tuannv-github/uwb-ips/README.md

# UWB indoor positioning system

Demo videos:
* https://www.youtube.com/watch?v=icayNw2rwgk
* https://www.youtube.com/watch?v=bJMFOIG7K60
