tuannv-github/uwb-ips/software/algorithm/multilateration/readme.md

# Source code for multilateration problem
## Generate sample data:
```
python location_generator.py
```
## Test Python implementation:
```
python multilateration.py
```
## Test Javascript implementation:
```
node multilateration.js
```
## Test C implementation:
```
gcc multilateration.c -o multilateration -lm
./multilateration
```
