tuannv-github/uwb-ips/firmware/apps/relay/README.md

```
newt target create relay
newt target set relay app=apps/relay
newt target set relay bsp=hw/bsp/nordic_pca10040_464
newt target set relay build_profile=optimized
newt build relay
newt create-image relay 0.0.0.0
newt load relay
```

```
newt target create relay
newt target set relay app=apps/relay
newt target set relay bsp=@apache-mynewt-core/hw/bsp/nordic_pca10040
newt target set relay build_profile=optimized
newt build relay
newt create-image relay 0.0.0.0
newt load relay
```

```
newt target create relay
newt target set relay app=apps/relay
newt target set relay bsp=@apache-mynewt-core/hw/bsp/nordic_pca10056
newt target set relay build_profile=optimized
newt target set relay syscfg=STATS_NAMES=1
newt build relay
newt create-image relay 0.0.0.0
newt load relay
```
