tuannv-github/uwb-ips/reports/thesis.tex

\documentclass[oneside, 12pt, a4paper]{book}

\usepackage[utf8]{inputenc}
\usepackage[english]{babel}

\usepackage{url}
\usepackage{tikz}
\usetikzlibrary{calc}
\usepackage{float}
\usepackage{ifthen}
\usepackage{siunitx}
\usepackage{lmodern}
\usepackage{amsmath}
\usepackage{listings}
\usepackage{graphicx}
\usepackage{subfiles}
\usepackage{biblatex}
\usepackage{csquotes}
\usepackage{tabularx}
\usepackage{multirow}
\usepackage{geometry}
\usepackage{enumitem}
\usepackage{pdfpages}
\usepackage{bytefield}
\usepackage{microtype}
\usepackage{alphabeta}
\usepackage{subcaption}
\usepackage{xcolor,colortbl}
% \usepackage[Lenny]{fncychap}
\usepackage[titletoc]{appendix}
\usepackage[hidelinks]{hyperref}

\usepackage{pythonhighlight}

\providecommand{\main}{.}
\addbibresource{\main/references.bib}   

\usepackage{\main/sty/slashbox}

\newboolean{printBibInSubfiles}
\setboolean{printBibInSubfiles}{true} 
\def\bib{\ifthenelse{\boolean{printBibInSubfiles}}
        {\printbibliography}
        {}
    }

\definecolor{Gray}{gray}{0.85}
\definecolor{LightCyan}{rgb}{0.2,0.7,1}

\newcolumntype{g}{>{\columncolor{Gray}}c}
\newcolumntype{w}{>{\columncolor{white}}c}
\newcolumntype{L}{>{\arraybackslash}X}
\newcolumntype{M}[1]{>{\centering\arraybackslash}m{#1\textwidth}}

\newlist{abbrv}{itemize}{1}
\setlist[abbrv,1]{label=,labelwidth=1in,align=parleft,itemsep=0.1\baselineskip,leftmargin=!}

\DeclareMathOperator*{\argmax}{argmax} 
\DeclareMathOperator*{\argmin}{argmin} 

\graphicspath{{img/}}

\geometry{
    left=20mm,
    right=20mm,
    top=20mm,
    bottom=20mm,
}

\setlength\parindent{0pt}

\definecolor{solarized@base03}{HTML}{002B36}
\definecolor{solarized@base02}{HTML}{073642}
\definecolor{solarized@base01}{HTML}{586e75}
\definecolor{solarized@base00}{HTML}{657b83}
\definecolor{solarized@base0}{HTML}{839496}
\definecolor{solarized@base1}{HTML}{93a1a1}
\definecolor{solarized@base2}{HTML}{EEE8D5}
\definecolor{solarized@base3}{HTML}{FDF6E3}
\definecolor{solarized@yellow}{HTML}{B58900}
\definecolor{solarized@orange}{HTML}{CB4B16}
\definecolor{solarized@red}{HTML}{DC322F}
\definecolor{solarized@magenta}{HTML}{D33682}
\definecolor{solarized@violet}{HTML}{6C71C4}
\definecolor{solarized@blue}{HTML}{268BD2}
\definecolor{solarized@cyan}{HTML}{2AA198}
\definecolor{solarized@green}{HTML}{859900}

\lstdefinestyle{CStyle}{
    language=C,
    basicstyle=\footnotesize\ttfamily,
    numbers=left,
    numberstyle=\footnotesize,
    tabsize=2,
    breaklines=true,
    escapeinside={@}{@},
    numberstyle=\tiny\color{solarized@base01},
    keywordstyle=\color{solarized@green},
    stringstyle=\color{solarized@cyan}\ttfamily,
    identifierstyle=\color{solarized@blue},
    commentstyle=\color{solarized@base01},
    emphstyle=\color{solarized@red},
    frame=single,
    rulecolor=\color{solarized@base2},
    rulesepcolor=\color{solarized@base2},
    showstringspaces=false
}

\lstdefinestyle{XMLStyle}{
    language=xml,
    tabsize=2,
    frame=single,
    xleftmargin=20pt,
    framexleftmargin=15pt,
    keywordstyle=\color{blue}\bf,
    commentstyle=\color{OliveGreen},
    stringstyle=\color{red},
    numbers=left,
    numberstyle=\tiny\color{solarized@base01},
    numbersep=5pt,
    breaklines=true,
    showstringspaces=false,
    basicstyle=\footnotesize,
    emphstyle={\color{magenta}},
    rulecolor=\color{solarized@base2},
    rulesepcolor=\color{solarized@base2},
    basicstyle=\footnotesize\ttfamily,
}

\begin{document}
\setboolean{printBibInSubfiles}{false}

\subfile{00_misc/cover.tex}

\clearpage
\setcounter{page}{1}

\subfile{00_misc/task.tex}
\subfile{00_misc/ack.tex}
\subfile{00_misc/assurance.tex}
\subfile{00_misc/abs.tex}

\tableofcontents

\subfile{00_misc/fig.tex}
\subfile{00_misc/tab.tex}
\subfile{00_misc/sym.tex}

\subfile{01_intro/introduction.tex}
\subfile{02_theory/ultra_wideband.tex}
\subfile{position_estimation/position_estimation.tex}

\subfile{03_firmware/firmware.tex}

\subfile{ble_mesh/ble_mesh.tex}

\subfile{04_hardware/hardware.tex}
\subfile{05_software/software.tex}
\subfile{06_result/result.tex}

\subfile{summary/summary.tex}

\begin{appendix}
    \includepdf[pages=1, pagecommand={
        \chapter{RTLS anchor board (Altium Designer)}
        \label{appendix:rtls_anchor_board}
    }, width=\textwidth, offset=0 -1cm]{\main/docs//RTLS-2021-01-09--13-27.PDF}

    \includepdf[pages=2-,pagecommand={},width=\textwidth]{\main/docs/RTLS-2021-01-09--13-27.PDF}
    
    \chapter{RTLS anchor enclosure (SolidWorks)}
    \label{appendix:rtls_anchor_enclosure}
    % \begin{figure}[H]
    %     \begin{center}
    %         \includegraphics[angle=90, width=0.65\textwidth]{Assem.JPG}
    %     \end{center}
    %     \caption{RTLS SolidWorks design}
    %     \label{fig:RTLS_SolidWork_Design}
    % \end{figure}
    % \begin{figure}[H]
    %     \centering
    %     \includegraphics[angle=90, width=0.65\textwidth]{anchor_final.jpg}
    %     \caption{RTLS anchor}
    %     \label{fig:RTLS_anchor}
    % \end{figure}
    \begin{figure}[H]
        \begin{center}
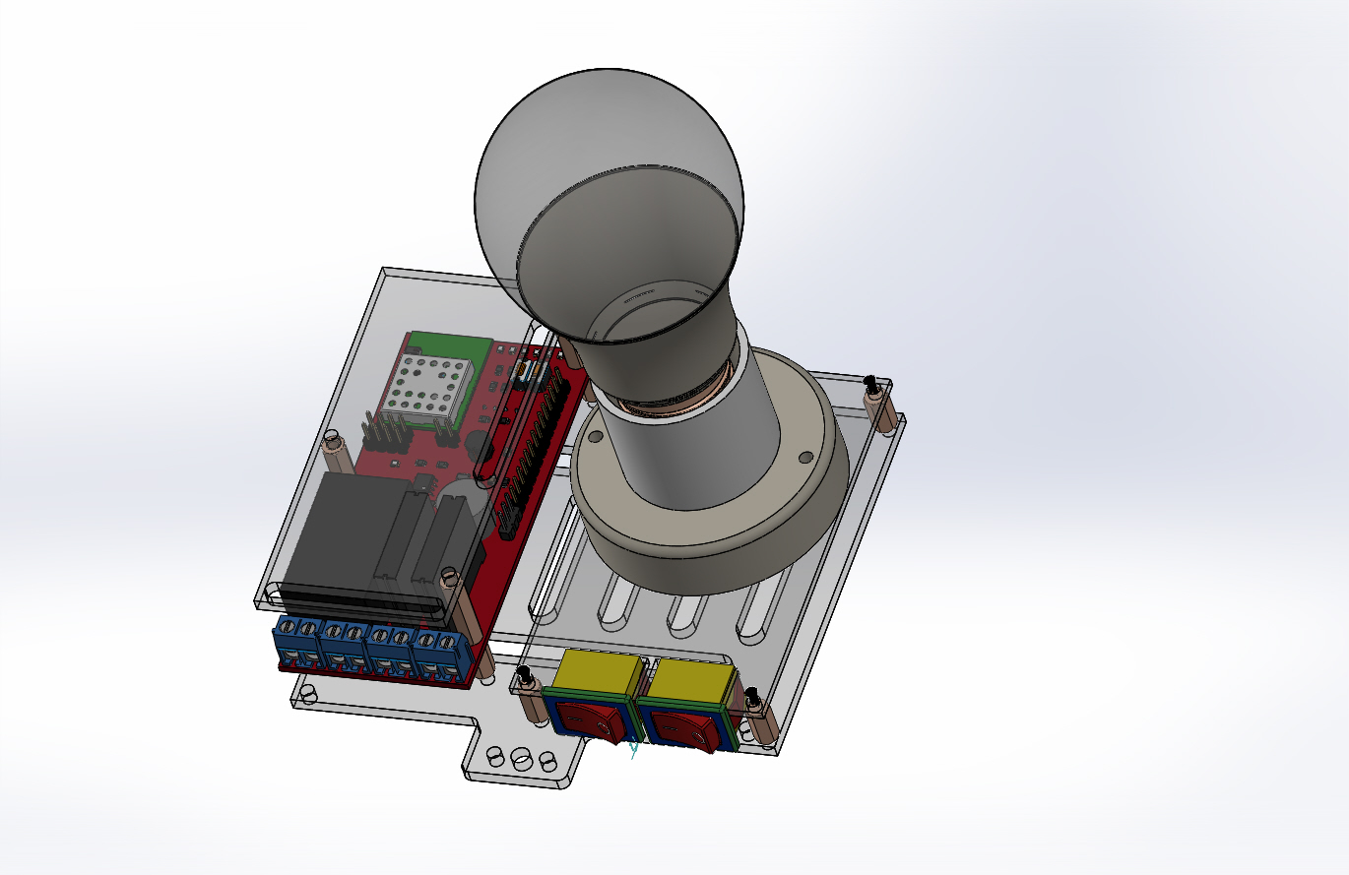
[picture p66: reports/imgs/Assem.JPG]
            
        \end{center}
        \caption{RTLS SolidWorks design}
        \label{fig:RTLS_SolidWork_Design}
    \end{figure}
    \begin{figure}[H]
        \centering
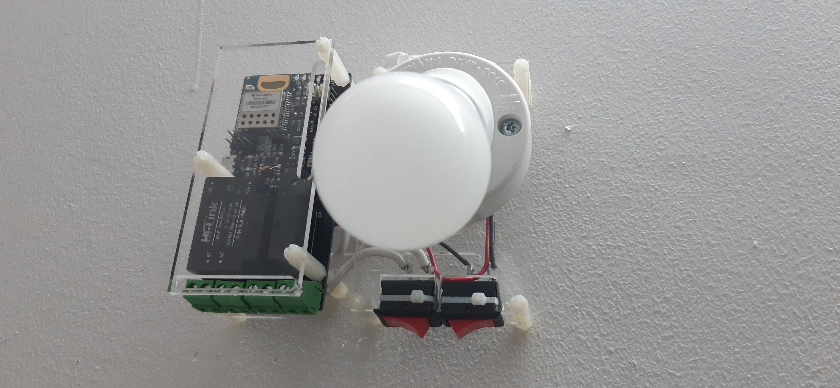
[picture p67: reports/img/anchor_final.jpg]
        
        \caption{RTLS anchor}
        \label{fig:RTLS_anchor}
    \end{figure}
\end{appendix}

\printbibliography[heading=bibintoc,title={References}]

\end{document}
