tuannv-github/uwb-ips/reports/00_misc/assurance.tex

\providecommand{\main}{..}
\documentclass[\main/thesis.tex]{subfiles}

\begin{document}
\graphicspath{{imgs/}{00_misc/imgs/}}

\chapter*{Assurance}
\addcontentsline{toc}{chapter}{Assurance}

My name is Ngo Van Tuan, I am a student at the Department of Electronics and Telecommunications, Ho Chi Minh University of Technology.
\newline\newline
I hereby declare that the following contents are true:
\begin{itemize}
    \item This research work is entirely done by myself;
    \item Materials and citations contained in this thesis are obtained from reputable sources with high accuracy;
    \item The data and results of this work are independently and honestly done by me;
\end{itemize}

In addition, a number of comments, reviews as well as data from other authors and organizations used in the thesis have clear citations and references.

\begin{flushright}
    \parbox[t][4cm]{8cm}
    {   \centering
        \today\\
        Student\\
        \vspace{2cm}
        Ngo Van Tuan
    }
\end{flushright}

\end{document}
