tuannv-github/uwb-ips/reports/00_misc/cover.tex

\providecommand{\main}{..}
\documentclass[\main/thesis.tex]{subfiles}

\begin{document}
\graphicspath{{imgs/}{00_misc/imgs/}}

    \pagestyle{empty}
    \begin{minipage}[b][3cm][t]{17.5cm}
        % Draw border
        \begin{tikzpicture}[remember picture, overlay]
            % Thin line
            \draw [line width=1pt]
                ($ (current page.north west) + (1.5cm,-1.5cm) $)
                rectangle
                ($ (current page.south east) + (-1.5cm,1.5cm) $);
            % Thick line
            \draw [line width=3pt]
                ($ (current page.north west) + (1.65cm,-1.65cm) $)
                rectangle
                ($ (current page.south east) + (-1.65cm,1.65cm) $); 
        \end{tikzpicture}

        \begin{center}
            \begin{large}
                    {VIETNAM NATIONAL UNIVERSITY HO CHI MINH CITY\\
                     HO CHI MINH CITY UNIVERSITY OF TECHNOLOGY\\
                     FACULTY OF ELECTRICAL AND ELECTRONICS  ENGINEERING\\
                     DEPARTMENT OF ELECTRONICS AND TELECOMMUNICATIONS}\\[0.2cm]
            \end{large}
            \textbf{*******************************************************}\\[1.5cm]
            \\[1.5cm]
                {\fontsize{20}{1}\selectfont Graduation Thesis }\\[1.5cm]
                {\fontsize{18}{24}\selectfont \textbf{\parbox[c][3cm]{15cm}{\centering DESIGN AND IMPLEMENTATION OF INDOOR LOCALIZATION SYSTEM USING UWB AND WIRELESS MESH NETWORK}} }\\[3.0cm]
        \end{center}

        {
            \fontsize{15}{1}\selectfont
            \begin{flushright}
            \parbox[t][4.5cm]{8cm}
            {
                Supervisor: Dr. Vo Que Son\\[4pt]
                % Reviewer: Dr. Vo Que Son\\[4pt]
                Student: Ngo Van Tuan - 1613861
            }
            \end{flushright}
        }
        
        \vspace{1cm}
        \begin{center}
            {\fontsize{14}{1}\selectfont Ho Chi Minh City, \today }
        \end{center}

    \end{minipage}
    \newpage
\end{document}
