tuannv-github/uwb-ips/reports/00_misc/sym.tex

\providecommand{\main}{..}
\documentclass[\main/thesis.tex]{subfiles}
\graphicspath{{img/}{00_misc/img/}}

\begin{document}

\chapter*{Symbols and acronyms}
\addcontentsline{toc}{chapter}{Symbols and Acronyms}
\begin{abbrv}
    \item[IPS]  Indoor positioning system
    \item[GPS]  Global positioning system 
    \item[SFD]  Start Frame Delimiter
    \item[SHR]  Synchronization Header
    \item[PHR]  Physical Header
    \item[PPDU] Physical Protocol Data Unit
    \item[PRF]  Pulse Repetition Frequency
    \item[MOSFET]  Metal-Oxide Semiconductor Field-Effect Transistor
    \item[ESR]  Equivalent Series Resistance
    \item[PDU] Packet Data Unit
    \item[IV] Initialization Vector
    \item[UUID] Universal Unique Identifier 
    \item[SOF] Single point of failure  
    \item[MQTT] Message Queuing Telemetry Transport 
    \item[QoS] Quality of Service
    \item[ToF] Time of Flight
    \item[TWR] Two-Way Ranging
    \item[CCP] Clock Calibration Packet  
    \item[TDMA] Time Division Multiple Access 
    \item[EIRP] Effective Isotropic Radiated Power
    \item[TH] Time-hoping 
    \item[RSSI] Received Signal Strength Indication
    \item[LoF] Line of Sight
    \item[RF] Radio Frequency 
    \item[UWB] Ultra-wide Band 
    \item[IR-UWB] Impulse-Radio Ultra-Wideband 
    \item[IoT] Internet of Things
\end{abbrv}

\end{document}
