tuannv-github/uwb-ips/reports/00_misc/task.tex

\providecommand{\main}{..}
\documentclass[\main/thesis.tex]{subfiles}

\begin{document}
\graphicspath{{imgs/}{00_misc/imgs/}}

% \noindent\makebox[\linewidth]{}

\rule{\textwidth}{1pt}
\begin{minipage}{0.45\textwidth}
    \vspace{3mm}
    \begin{center}
        \fontsize{7}{12}\selectfont{VIETNAM NATIONAL UNIVERSITY HO CHI MINH CITY\\
                 HO CHI MINH CITY UNIVERSITY OF TECHNOLOGY\\}
    \rule{\textwidth}{1pt}
    \end{center}
\end{minipage}
\hfill
\begin{minipage}{0.45\textwidth}
    \vspace{3mm}
    \begin{center}
        \fontsize{7}{12}\selectfont{SOCIALIST REPUBLIC OF VIETNAM\\
    INDEPENDENCE-FREEDOM-HAPPINESS\\}
    \rule{\textwidth}{1pt}
    \end{center}
\end{minipage}

\begin{flushleft}
    \parbox[t][1.5cm]{10cm}
    {
        Number: ....................... /BKĐT \\
        Faculty: Electrical and Electronics Engineering \\
        Department: Telecommunications
    }
\end{flushleft}

\vspace{3mm}
\begin{center}
    \textbf{THESIS MISSION}
\end{center}
\vspace{3mm}

\begin{enumerate}
    \item Student name: Ngo Van Tuan \hspace{3cm} Student ID: 1613861
    \item Faculty: Electrical and Electronics
    \item Department: Telecommunications
    \item Topic: Design and implementation of indoor localization system using UWB and wireless mesh network 
    \item Task: \begin{itemize}
        \item Design and implement an indoor localization system using UWB
        \item Build a system to manage and control the localization system based on Bluetooth mesh network.
    \end{itemize}
    \item Start date: 20/9/2020
    \item Due date: 11/1/2020
    \item Supervisor: Dr. Vo Que Son, Department of Telecommunications
\end{enumerate}

Contents and requirements have been accepted by the department.
\newline\newline
Ho Chi Minh City, \today

\vspace{10mm}

\begin{minipage}{0.45\textwidth}

    \begin{center}
        \textbf{\fontsize{14}{12}\selectfont{
            HEAD OF DEPARTMENT}}\\
            \vspace{2cm}
            Assoc. Prof. Ha Hoang Kha
    \end{center}
\end{minipage}
\hfill
\begin{minipage}{0.45\textwidth}
    \begin{center}
        \textbf{\fontsize{14}{12}\selectfont{SUPERVISOR}} \\
        \vspace{2cm}
        Dr. Vo Que Son
    \end{center}
\end{minipage}

\newpage
% PH DÀNH CHO KHOA, B¸ M˘N:

\textbf{Department area}

Approved by:

Department:

Thesis defense date:

Score:

Storage location:

\end{document}
