tuannv-github/uwb-ips/reports/02_theory/ultra_wideband.tex

\providecommand{\main}{..}
\documentclass[\main/thesis.tex]{subfiles}

\begin{document}
\graphicspath{{img/}{02_theory/img/}}

% \chapterimage{chapter_head_1.pdf}
\chapter{Ultra-Wideband Signals}

This chapter provides a quick explanation of UWB along with its advantages and regulations. The later 2 sections also give a modulation scheme and the IEEE standard for UWB.

\section{Definition of Ultra-Wideband System}

With $f$\textsubscript{c} is the frequency in which the system has the maximum power density and the frequencies $f$\textsubscript{h} and $f$\textsubscript{L} determine the location where the power of spectral density is 10dB less then the $f$\textsubscript{c}. $B$\textsubscript{frac} is defined as 
\begin{equation}
    B\textsubscript{frac}=\frac{B}{f\textsubscript{c}}
\end{equation} where $B$ is the bandwidth of the system.

In term of high and low frequencies, we have: 
\begin{equation}
    B=(f\textsubscript{H} - f\textsubscript{L})
\end{equation}
and 
\begin{equation}
    f\textsubscript{c} = \frac{f\textsubscript{H} + f\textsubscript{L}}{2}\
\end{equation} 
so 
\begin{equation}
    B\textsubscript{frac} = \frac{2(f\textsubscript{H} - f\textsubscript{L})}{f\textsubscript{H} + f\textsubscript{L}}
\end{equation}

The Federal Communication Commission (FCC) has define UWB systems as those which have an absolute bandwidth larger than 500Mhz and $f$\textsubscript{c} larger than 2.5 GHz, or have a $B$\textsubscript{frac} larger than 0.2 for system with $f$\textsubscript{c} lower than 2.5GHz \cite{ultra_wideband_positioning_systems}.

Ultra-Wideband radio is also referred as ‘impulse’, ‘short-pulse’, ‘non-sinusoidal’, ‘carrierless’, ‘time domain’, ‘super wideband’, ‘fast frequency chirp’ and ‘mono-pulse’ radio.

Very short pulse transmissions that result in an ultra-wideband spectrum are both utilized by impulse radio communication systems and impulse radars. Since the data modulation is introduced by pulse position modulation,  this communication manner is also classified as a pulse modulation technique (PPM).

Due to the low-power spectral density, the UWB signal is noise-like which make the interception and detection quite difficult. On the other hand, this makes UWB cause very little interference with existing narrow-band radio systems. Moreover, UWB might operate without license depend on the attitude of national and international regulatory bodies.

One result of the large bandwidth of UWB is that due to the inverse relationship of
time and frequency. Figure \ref{fig:uwb_versus_other_radio_communication_systems} shows the differences between UWB and other radio systems in the frequency band and power spectral density.

\begin{figure}[H]
    \centering
    
    \caption{UWB versus other radio communication systems}
    \label{fig:uwb_versus_other_radio_communication_systems}
\end{figure}

\section{Advantages of Ultra-Wideband}

Below \cite{uwb_theory_and_applications} are some advantages that make it attractive for consumer communication applications.
\begin{itemize}
    \item Potentially low complexity and low cost
    \item Noise like signal
    \item Resistant to multi-path and jamming
    \item Good time-domain resolution allowing for localization and tracking application.
\end{itemize}

The base-band nature of signal transmission reduces the complexity and cost of UWB systems.
Unlike conventional radio systems, a very short time-domain pulse produced by the UWB transmitter is able to propagate without the need of an additional RF mixing stage. 
% The RF mixing stage takes a base-band signal and `inject' carrier frequency or translates the signal to a frequency which has desirable propagation characteristic. 
% The very nature of the UWB signal means it spans frequencies commonly used as carrier frequencies. 
% The signal will propagate well without the need of additional up-conversion and amplification. 
There is no need of additional up-conversion and amplification and the sender side.
The reverse process of down-conversion is also not required in the UWB receiver. This means the omission of a local oscillator in the receiver, and the removal of associated complex delay and phase tracking loop. Consequently, a UWB system can be implemented in low cost, low power, integrated circuit process.

One of the most important topics in current UWB research is the interference phenomenon between impulse radio and existing radio systems. While there is some debate in the literature, it appears that low power, noise-like, UWB transmission does not significantly interfere existing radio systems. The low energy of and the pseudo-random (PR) characteristics of the UWB signal, however, make it noise-like, thus making it quite difficult to detect unintended signals. 

% Time-modulation systems offer a possibility for high data rates for communication. Hundreds of Mbps have been reported for communication links.

Using UWB technology, a very high multi-path resolution is achieved because of the large bandwidth of the transmitted signal. The large bandwidth offers huge frequency diversity which, together with the discontinuous transmission, make the UWB signal resistant to severe multi-path propagation and jamming/interference. 

The very narrow time-domain pulse of UWB radios means that it is potentially able to offer timing precision much better than other radio systems. Together with good material penetration properties, UWB signals offer opportunities for short-range radar applications such as rescue and anti-crime operations, as well as in surveying and the mining industry. UWB does not provide precise timing and extreme penetration at the same time, but UWB waveforms present a better choice than do conventional radio systems.

\section{International Regulations for UWB Signals}

The effective isotropic radiated power (EIRP) which can be defined as the product of its gain and input power is one important feature of a radar and communications transmitter . Figure \ref{fig:fcc_spectral_mask_for_indoor_uwb_systems} shows the FCC spectral mask of the indoor UWB EIRP emission level. It is evidence that the maximum signal power is limited to -41.3 dBm per MHz throughout the whole UWB frequency range from 3.1 to 10.6 GHz. To comply with the FCC standards and regulations, all UWB systems and devices must work within this spectral mask for legal operation.

\begin{figure}[H]
    \centering
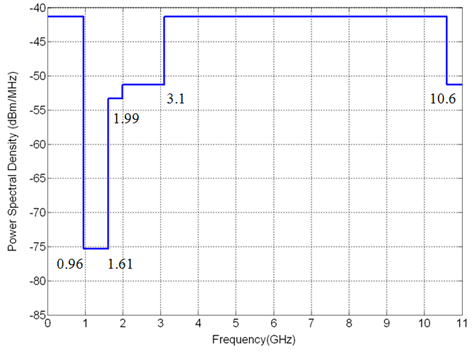
[picture p68: reports/02_theory/img/fcc_spectral_mask_for_indoor_uwb_systems.png]
    
    \caption{FCC spectral mask for indoor UWB systems}
    \label{fig:fcc_spectral_mask_for_indoor_uwb_systems}
\end{figure}

\section{Relationship of Bandwidth with Data Rate and Power Consumption}
As indicated by the Shannon-Harley theorem, there is a direct relationship between capacity and bandwidth and an inverse relationship between bandwidth and power consumption. Their theorem states: 
\begin{equation}
    C=B\log_2(1+\frac{S}{N})
\end{equation} where $C$ is the capacity ($bits/second$), $B$ is the bandwidth, $S$ is the average received signal power over $B$ and $N$ is the average noise over $B$. 

For a specific capacity, it consumes less power with a larger bandwidth. Since $\frac{S}{N}$ is under a logarithm, it is easier to increase the capacity by increasing of the bandwidth instead of $\frac{S}{N}$. It is common to refer to $\frac{S}{N}$ as SNR, the Signal to Noise Ratio. Figure \ref{fig:capacity_versus_bandwidth_curves_for_uwb_systems_over_awgn_channels} \cite{ultra_wideband_positioning_systems} shows the relationship between the bandwidth and the capacity for five different SNRs.

\begin{figure}[H]
    \centering
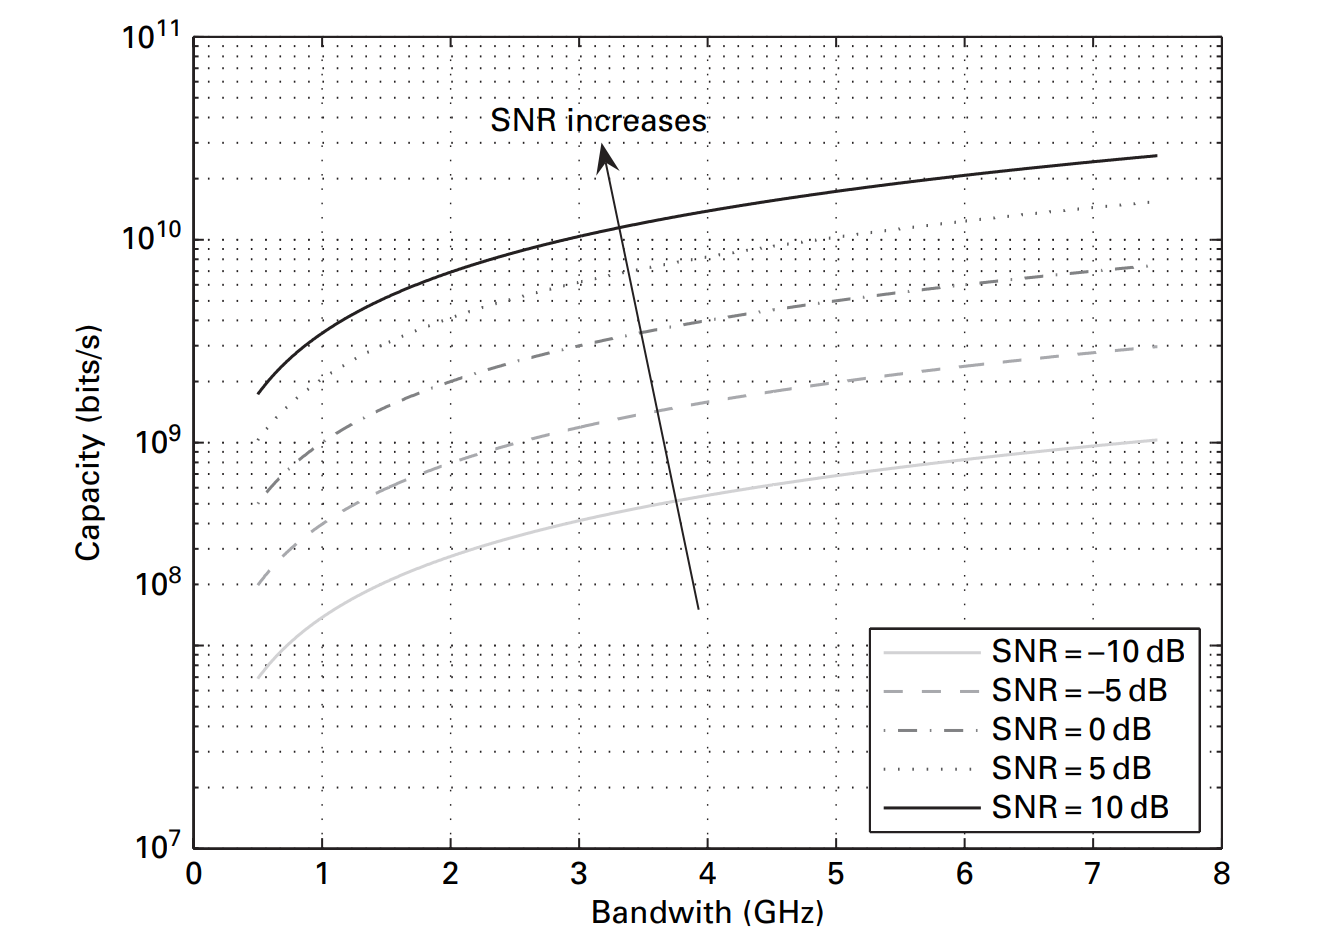
[picture p69: reports/02_theory/img/capacity_versus_bandwidth_curves_for_uwb_systems_over_awgn_channels.PNG]
    
    \caption{Capacity versus bandwidth curves for UWB systems over AWGN channels}
    \label{fig:capacity_versus_bandwidth_curves_for_uwb_systems_over_awgn_channels}
\end{figure}

\section{An UWB Modulation Scheme: Impulse Radio Scheme}

Time-modulated ultra wide-band (TM-UWB) communication is based on discontinuous emission of very short Gaussian pulses or other types of pulse waveforms (monocycles).

As in figure \ref{fig:an_ir_uwb_signal} \cite{ultra_wideband_positioning_systems}, data is transmitted by low duty UWB signals information of the symbol is conveyed by position and/or polarity of the signal. Each symbol corresponds to one or more signals. In the following example, two consecutive IR signals represent one symbol. The IR signal can occupy one of the chip-intervals($T\textsubscript{$c$}$) within a frame ($T\textsubscript{$f$}$). A time-hoping (TH) code is used for determining the accurate position of a signal in a dedicated time frame to decrease the chance of interference between UWB systems. 

% In the following example, the TH codes for the symbols are \{2,1\}, \{2,3\} and \{1,0\} respectively, 
% In this example, the information corresponds to the polarity of the signals, so the IR stream represents the binary data `101'. This technique is commonly known as Binary Phase Shifts Keying (BPSK).

\begin{figure}[H]
    \centering
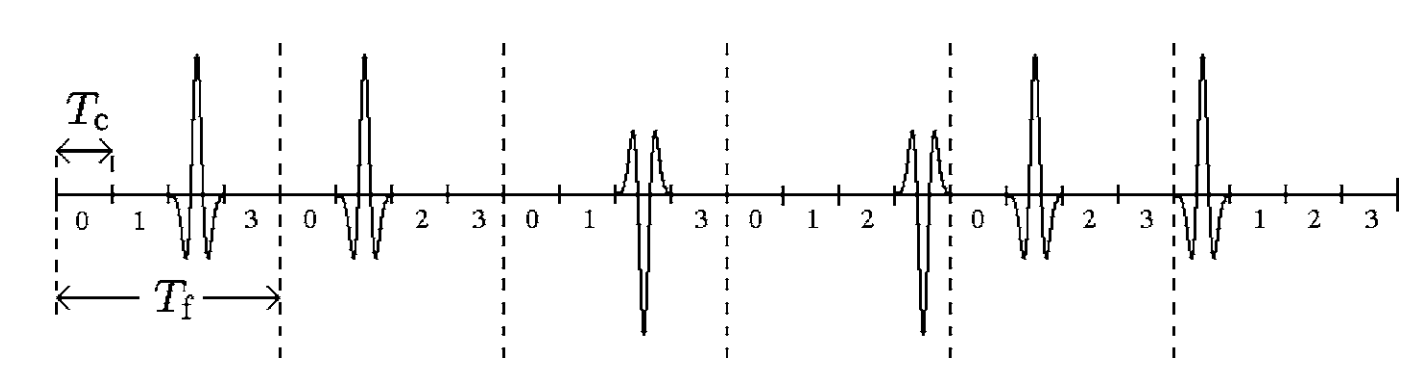
[picture p70: reports/02_theory/img/an_ir_uwb_signal.PNG]
    
    \caption{An IR UWB signal}
    \label{fig:an_ir_uwb_signal}
\end{figure}

An IR UWB signal, in which two pulses are transmitted per information symbol, and information is conveyed by the polarities of the pulses (BPSK). Hence, +1, -1 and +1 are being transmitted in the example shown in figure \ref{fig:an_ir_uwb_signal}. Note that each pulse resides in an interval of $T\textsubscript{$f$}$ seconds, called a “frame’’, and the positions of the pulses in different frames are determined by a TH (Time-hoping) code, which is {2, 1, 2, 3, 1, 0} in the example, so the first and the second signals are shifted by two and one chip-interval respectively and so on. 

\section{IEEE 802.15.4a Standard}
A new physical layer concept for low data rate applications utilizing UWB technology has been defined by the 802.15.4a study group \cite{IEEE_Std_802_15_4_2015}. Applications that require only moderate data throughput, but long battery life such as low-rate wireless personal area networks, sensors, and small networks are well-suited to UWB technology.

The IEEE 802.15.4a specifies two optional signaling formats based on  impulse-radio Ultra-Wideband (IR-UWB) and chirp spread spectrum (CSS). The IR-UWB option can use 250–750 MHz, 3.244-4.742 GHz, or 5.944-10.234 GHz bands; whereas the CSS uses the 2.4–2.4835 GHz band. For the IR-UWB there is an optional ranging capability, whereas the CSS signals can only be used for communications purposes. Only the IR-UWB option of the IEEE 802.15.4a standard is studied in this thesis.

\subsubsection{Channel allocations}
According to the IEEE 802.15.4 standard, a UWB device can transmit in one or more of the following bands:
\begin{itemize}
    \item Sub-GHz: 250 - 750 MHz
    \item Low band: 3.244- 4.742 GHz
    \item High band: 5.944 - 10.234 GHz.
\end{itemize}

Over these three bands, there are 16 channels supported for the UWB PHY: 1 in the sub-GHz band, 4 in the low band and 11 in the high band. These channels, their center frequencies as well as bandwidths are listed in table \ref{tab:uwb_channels_for_the_IEEE_802_15_4a_standard} together with mandatory channels in each band.

\begin{table}[H]
    \centering
    \begin{tabular}{ |c|c|c|c|c| } 
        \hline
        Channel No. & Center freq. (MHz) & Bandwidth (MHz) & UWB band & Mandatory \\\hline
        0& 499.2& 499.2& Sub-GHz& Yes \\\hline
        1& 3494.4& 499.2& Low band& No \\\hline
        2& 3993.6& 499.2& Low band& No \\\hline
        3& 4492.8& 499.2& Low band& Yes \\\hline
        4& 3993.6& 1331.2& Low band& No \\\hline
        5& 6489.6& 499.2& High band& No \\\hline
        6& 6988.8& 499.2& High band& No \\\hline
        7& 6489.6& 1081.6& High band& No \\\hline
        8& 7488.0& 499.2& High band& No \\\hline
        9& 7987.2& 499.2& High band& Yes \\\hline
        10& 8486.4& 499.2& High band& No \\\hline
        11& 7987.2& 1331.2& High band& No \\\hline
        12& 8985.6& 499.2& High band& No \\\hline
        13& 9484.8& 499.2& High band& No \\\hline
        14& 9984.0& 499.2& High band& No \\\hline
        15& 9484.8& 1354.97& High band& No \\\hline
    \end{tabular}
    \caption{UWB channels for the IEEE 802.15.4a standard}
    \label{tab:uwb_channels_for_the_IEEE_802_15_4a_standard}
\end{table}

The DWM1001 module has a built-in antenna for UWB channel 5.
\bib
\end{document}
