tuannv-github/uwb-ips/reports/03_firmware/mynewt_os.tex

\providecommand{\main}{..}
\documentclass[\main/main.tex]{subfiles}

\begin{document}
\graphicspath{{img/}{03_firmware/img/}}

\chapter{Apache Mynewt OS}

\section{Why Mynewt OS?}
This section covers several points for answering the question: why Mynewt OS is chosen for this thesis. However, before going into details, let's talk about: what is Mynewt OS and its main purpose.

Apache Mynewt is an open-source operating system for tiny embedded devices. Its goal is to make it easy to develop applications for microcontroller environments where \textbf{power} and \textbf{cost} are driving factors. It is also designed to build, deploy and securely manage billions of devices.

\subsection{Built for wireless}

\subsection{Security from the start}

\subsection{Operations ready}

\subsection{Cross-platform}

\subsection{Easy to use}

\end{document}
