tuannv-github/uwb-ips/reports/trash/trilateration.tex

\documentclass[./main.tex]{subfiles}

\begin{document}

\chapter{True range multilateration problem}

True-range multilateration is a method to determine the location of a movable or stationary device in space using multiple ranges (distances) between the device and multiple spatially-separated known locations.

\end{document}
