tuannv-github/uwb-ips/hardware/altium/hardware.txt

https://tiki.vn/bong-den-led-bulb-doi-mau-9w-rang-dong-p23224173.html
https://hshop.vn/products/module-nguon-ac-dc-hi-link-hlk-pm12-12vdc-3w
https://icdayroi.com/cam-bien-nhiet-do-va-do-am-i2c-am2320
