tuannv-github/uwb-ips/reports/01_intro/img/fonctionnement-technologie-mesh-wirepas.jpg

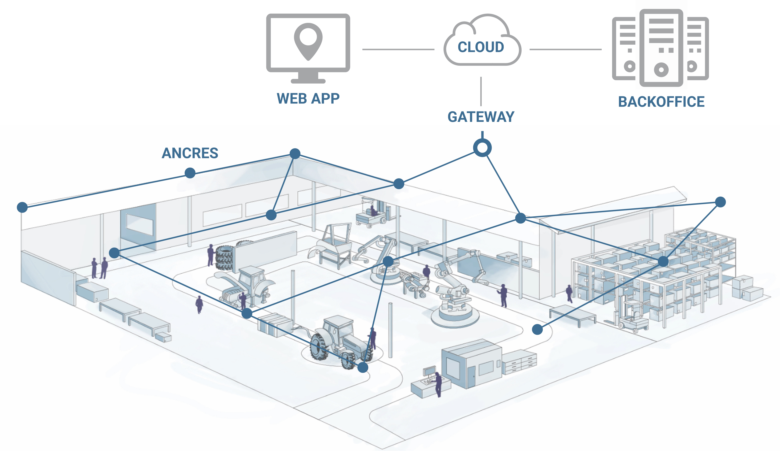
reports/01_intro/img/fonctionnement-technologie-mesh-wirepas.jpg
