tuannv-github/uwb-ips/reports/02_theory/img/aoa_crlb_versus_psi_for_various_pulse_widths.PNG

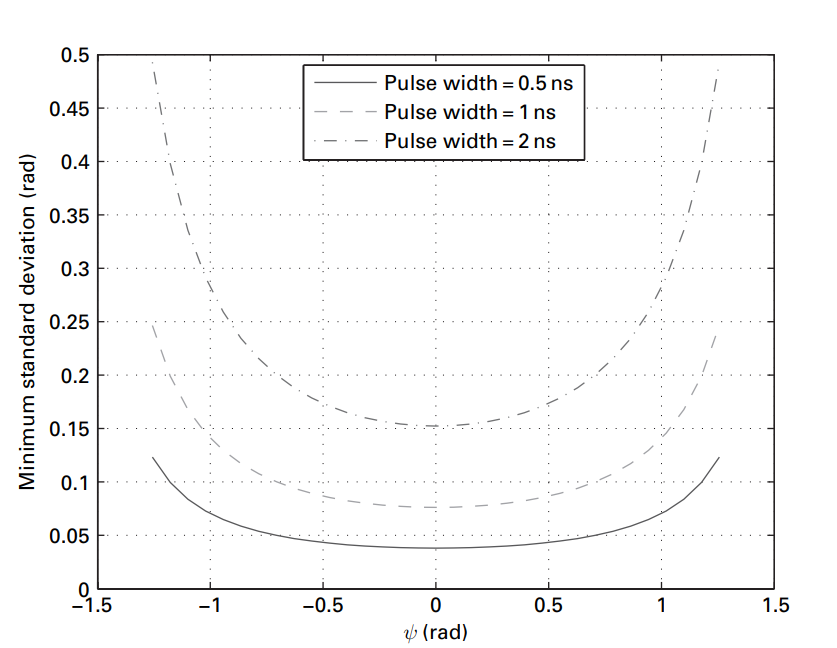
reports/02_theory/img/aoa_crlb_versus_psi_for_various_pulse_widths.PNG
