tuannv-github/uwb-ips/reports/02_theory/img/ccp_slave_flow_chart.png

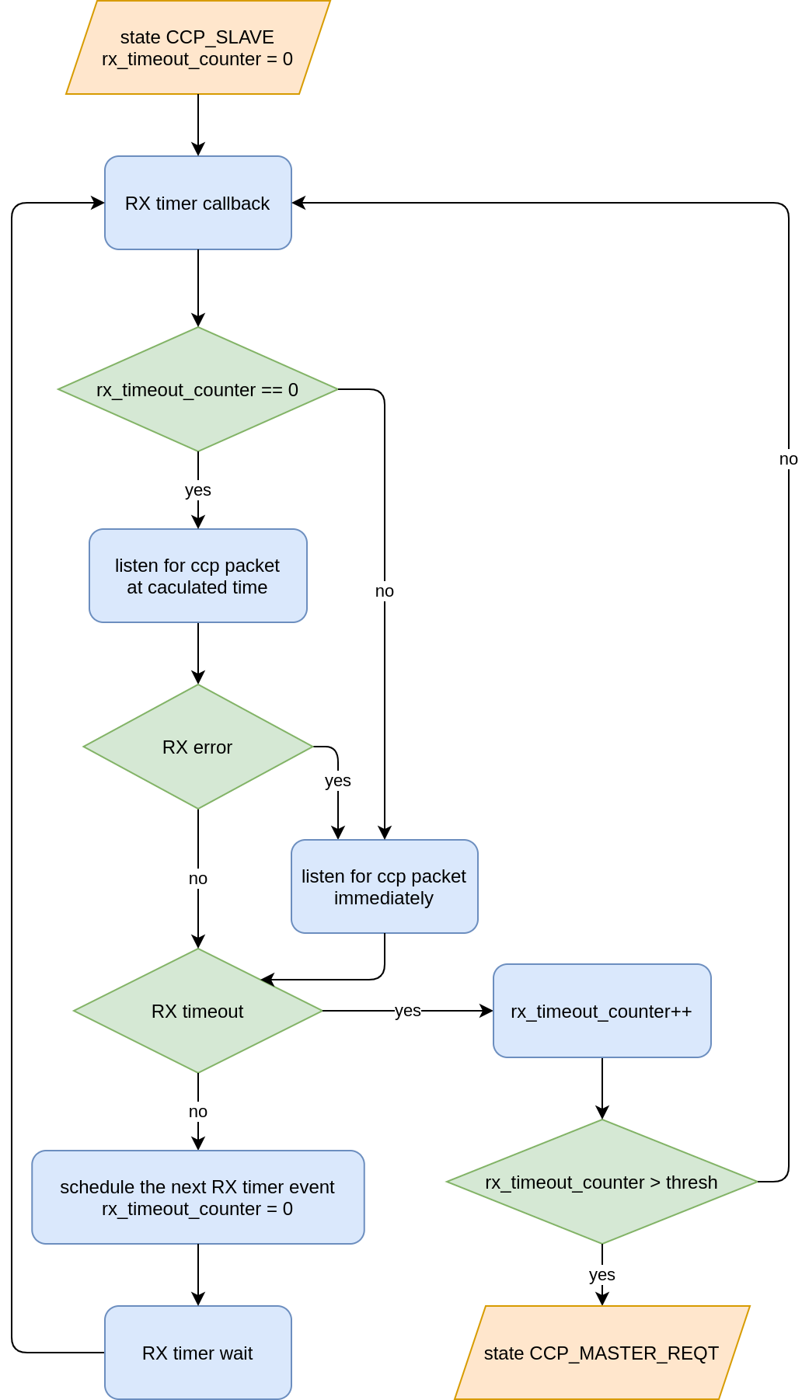
reports/02_theory/img/ccp_slave_flow_chart.png
