tuannv-github/uwb-ips/reports/03_firmware/img/ccp_repeat.png

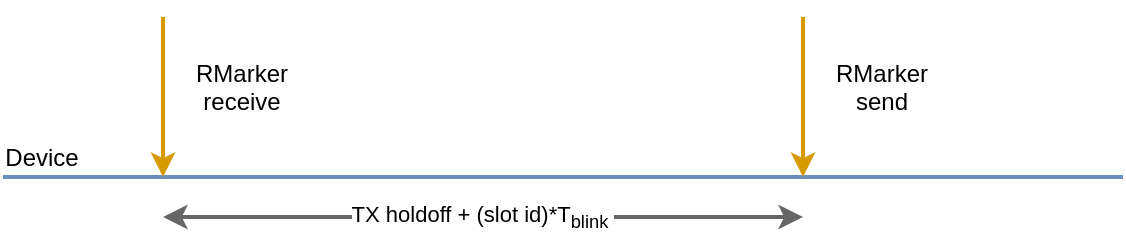
reports/03_firmware/img/ccp_repeat.png
