tuannv-github/uwb-ips/reports/03_firmware/img/interupt_latency_listener.png

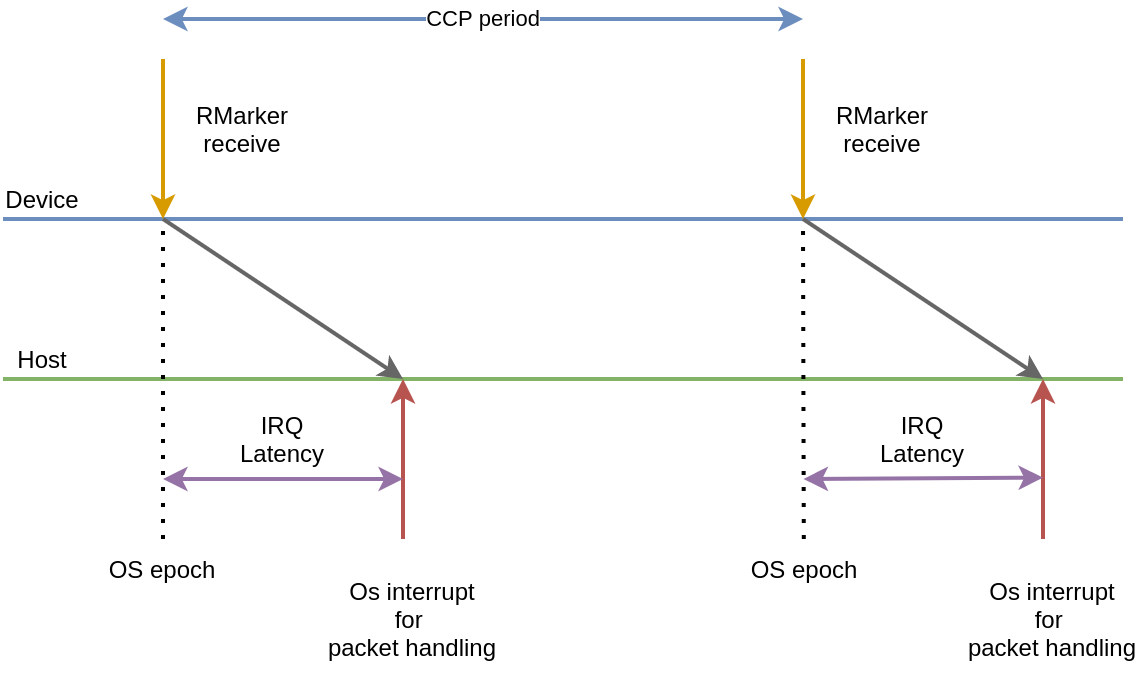
reports/03_firmware/img/interupt_latency_listener.png
