tuannv-github/uwb-ips/reports/03_firmware/img/interupt_latency_master.png

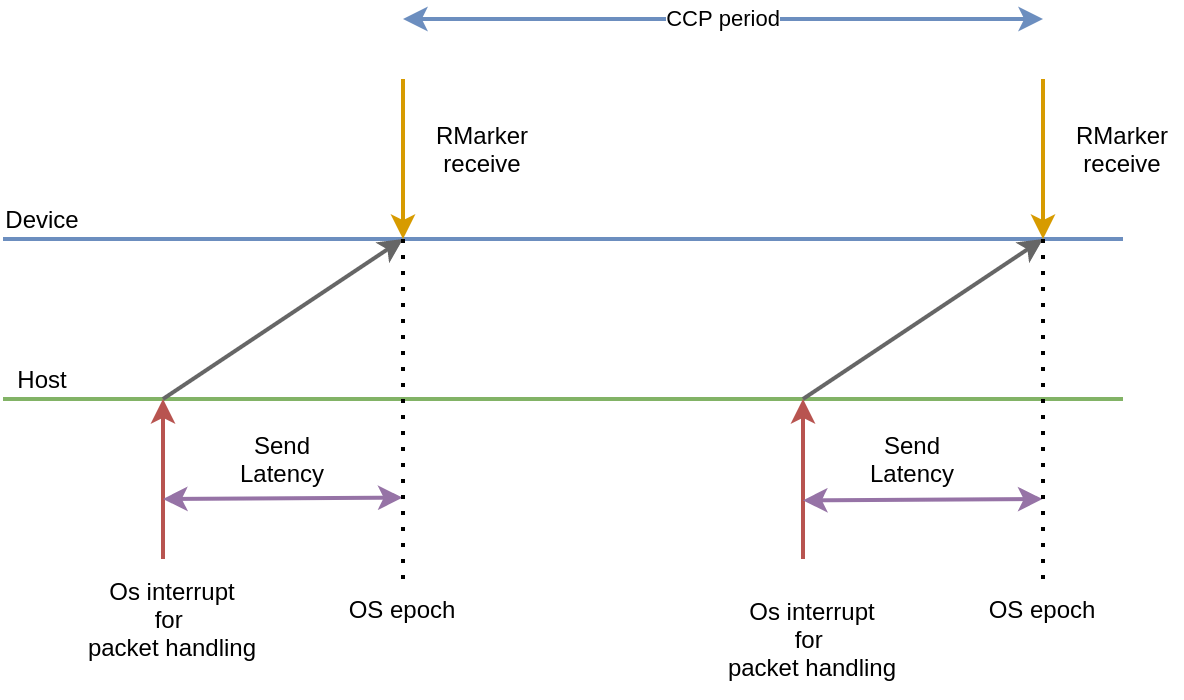
reports/03_firmware/img/interupt_latency_master.png
