tuannv-github/uwb-ips/reports/04_hardware/img/relay_circuit.png

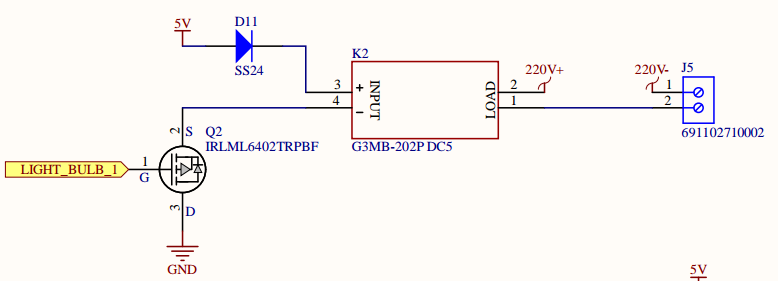
reports/04_hardware/img/relay_circuit.png
