tuannv-github/uwb-ips/reports/05_software/img/4d7cc9dc05113e97600e294c4b070f13.png

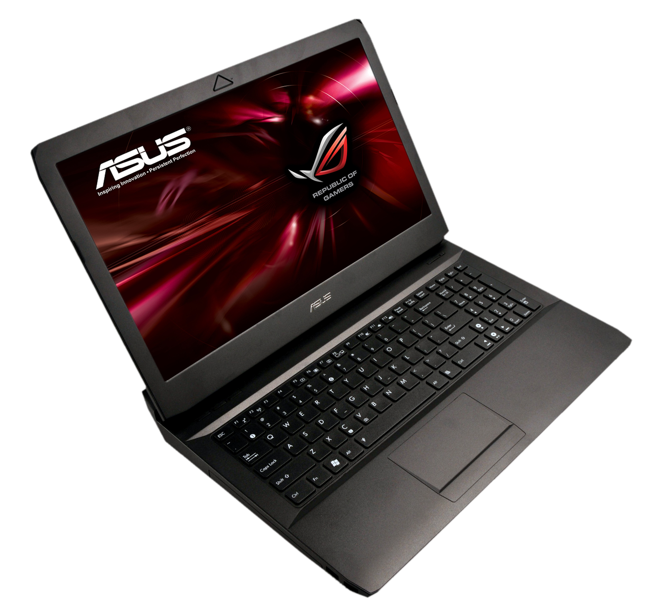
reports/05_software/img/4d7cc9dc05113e97600e294c4b070f13.png
