tuannv-github/uwb-ips/reports/05_software/img/468-4687624_asus-laptop-asus-hd-png-download.png

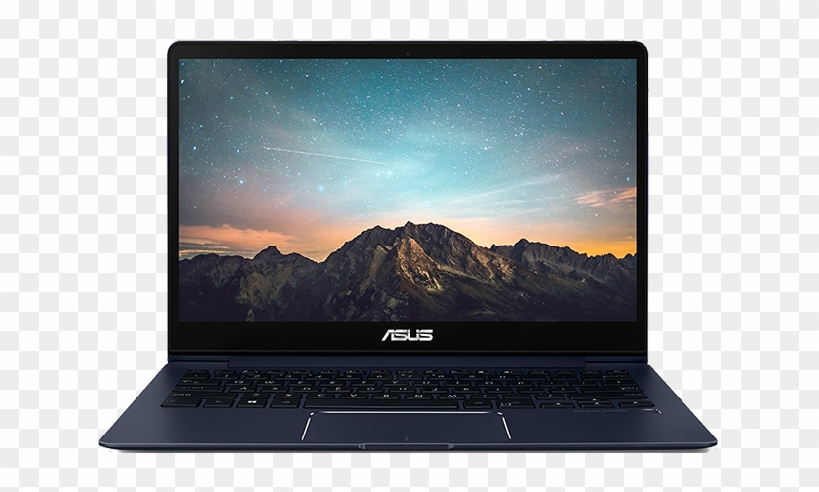
reports/05_software/img/468-4687624_asus-laptop-asus-hd-png-download.png
