tuannv-github/uwb-ips/reports/05_software/img/mqtt_qos_0.jpg

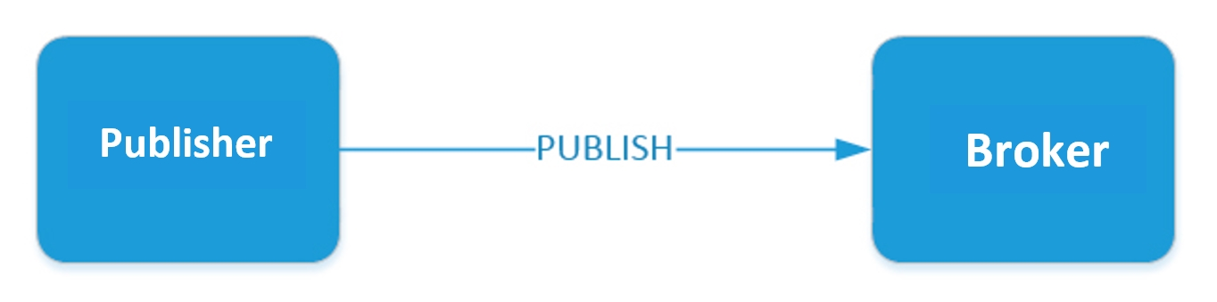
reports/05_software/img/mqtt_qos_0.jpg
