tuannv-github/uwb-ips/reports/05_software/img/mqtt_qos_2.jpg

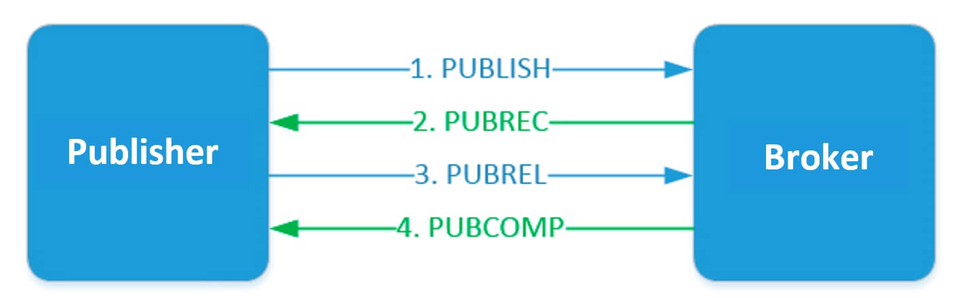
reports/05_software/img/mqtt_qos_2.jpg
