tuannv-github/uwb-ips/reports/05_software/img/nRF52832 QFA.png

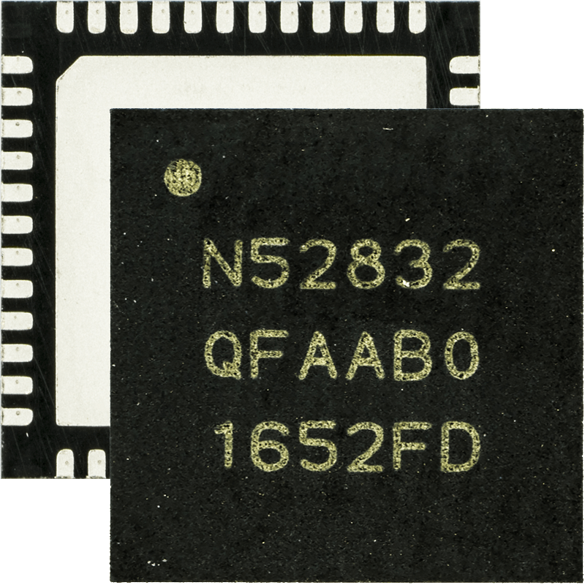
reports/05_software/img/nRF52832 QFA.png
