tuannv-github/uwb-ips/reports/ble_mesh/img/ble_mesh_pub_sub.png

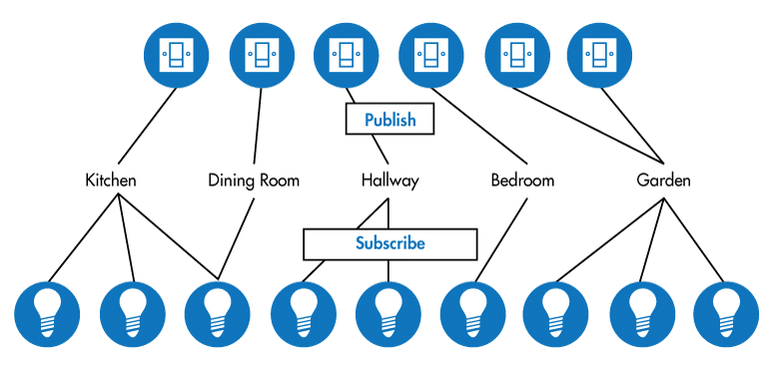
reports/ble_mesh/img/ble_mesh_pub_sub.png
