tuannv-github/uwb-ips/reports/ble_mesh/img/ble_mesh_stack.png

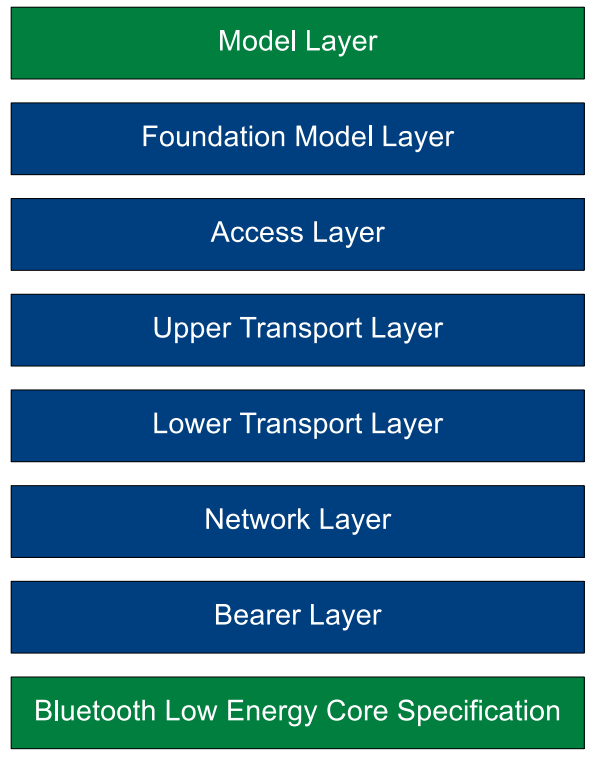
reports/ble_mesh/img/ble_mesh_stack.png
