tuannv-github/uwb-ips/reports/ble_mesh/img/mesh_topo.png

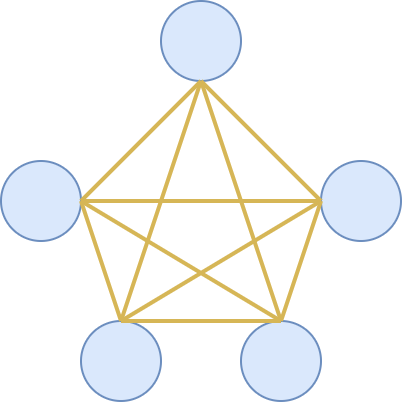
reports/ble_mesh/img/mesh_topo.png
