tuannv-github/uwb-ips/reports/ble_mesh/img/node_software_architecture.jpg

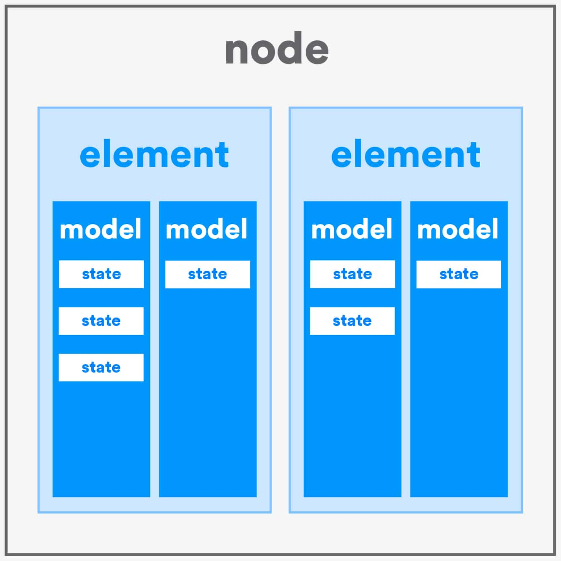
reports/ble_mesh/img/node_software_architecture.jpg
