tuannv-github/uwb-ips/reports/img/gps-src.png

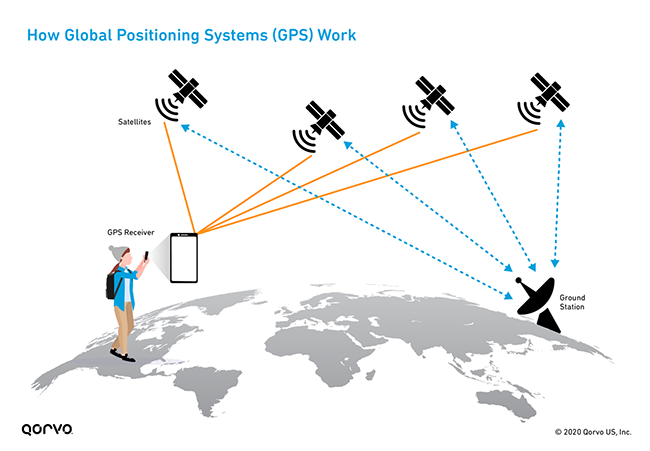
reports/img/gps-src.png
