tuannv-github/uwb-ips/reports/img/ips-src.png

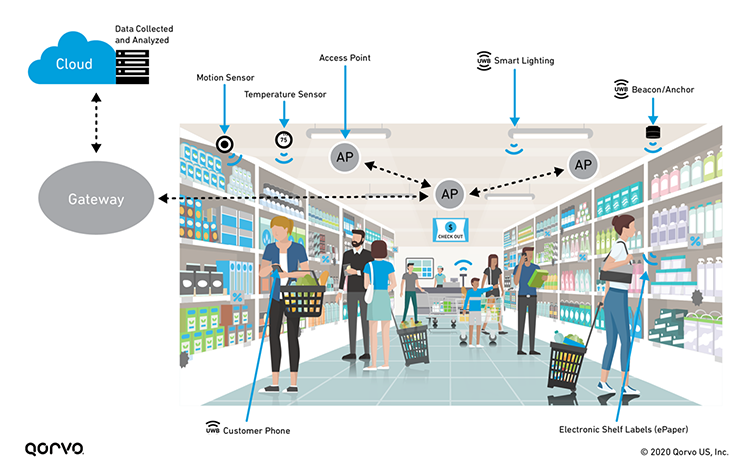
reports/img/ips-src.png
