tuannv-github/uwb-ips/reports/position_estimation/img/PDoAImage-253x300.png

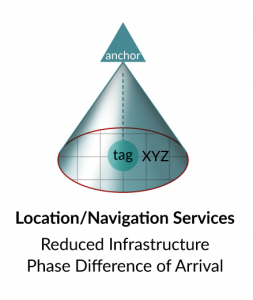
reports/position_estimation/img/PDoAImage-253x300.png
