tuannv-github/uwb-ips/reports/position_estimation/img/TDoAImage-300x274.png

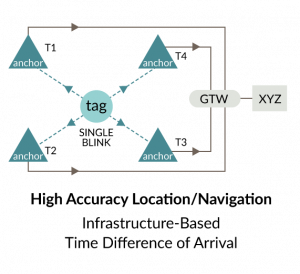
reports/position_estimation/img/TDoAImage-300x274.png
