tuannv-github/uwb-ips/reports/position_estimation/img/TWRImage-279x300.png

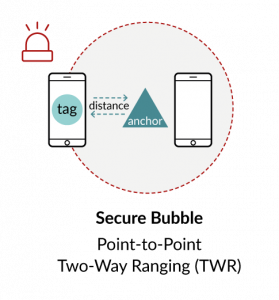
reports/position_estimation/img/TWRImage-279x300.png
