tuannv-github/uwb-ips/hardware/solidworks/house/Hex Spacer/Hex Spacer MF M3 L10mm.stp

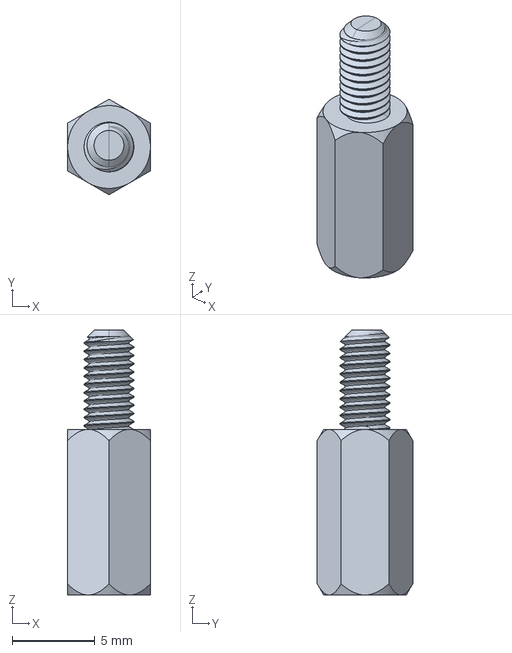
[picture p128: CAD file, 2021-01-04]
hardware/solidworks/house/Hex Spacer/Hex Spacer MF M3 L10mm.stp
5.00 x 5.77 x 16.0 mm
