tuannv-github/uwb-ips/hardware/solidworks/house/rocker_switch.SLDPRT

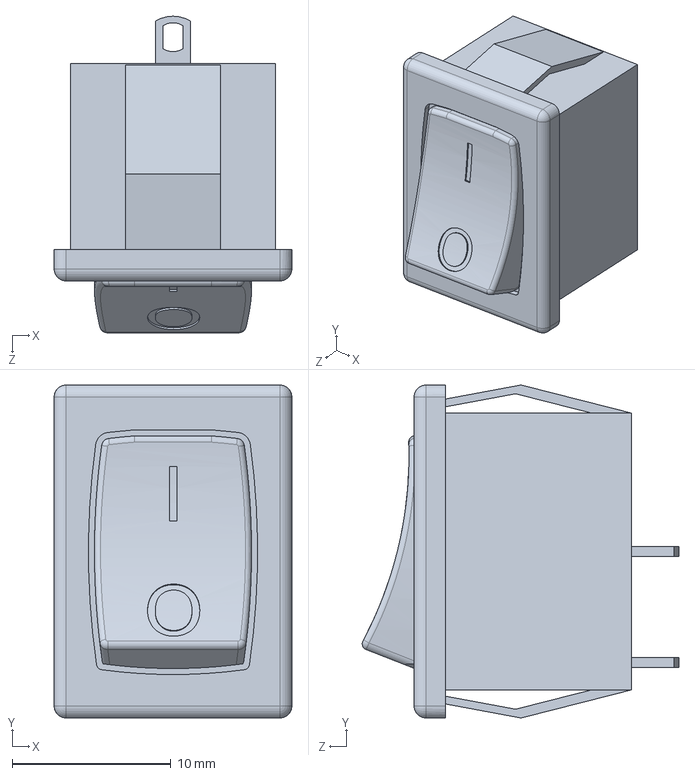
[picture p129: CAD file, 2021-01-04]
hardware/solidworks/house/rocker_switch.SLDPRT
15.0 x 21.0 x 20.0 mm
