tuannv-github/uwb-ips/hardware/solidworks/hook/bat_RCR123A.STEP

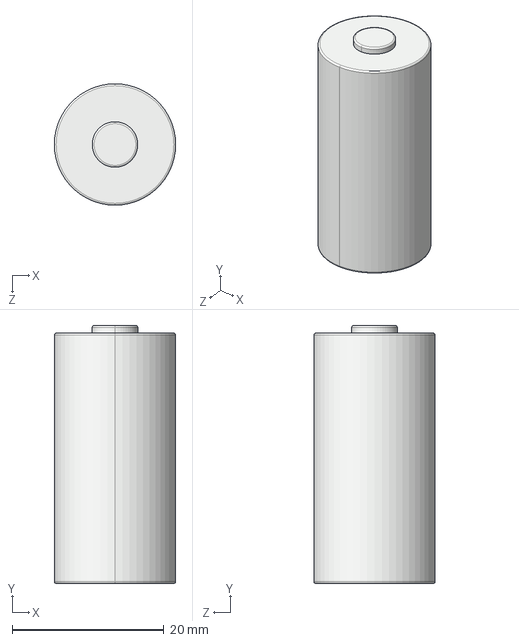
[picture p130: CAD file, 2021-01-04]
hardware/solidworks/hook/bat_RCR123A.STEP
16.0 x 34.0 x 16.0 mm
