tuannv-github/uwb-ips/hardware/solidworks/house/Hex Spacer/Hex Spacer MF M3 L40mm.stp

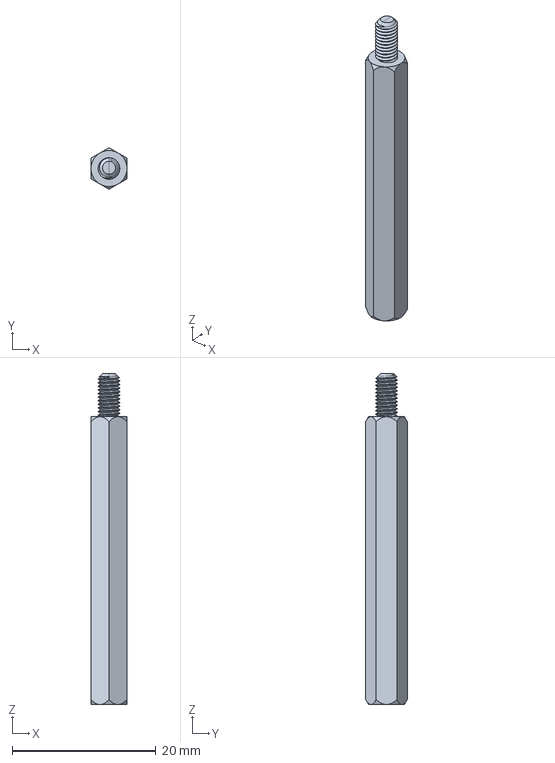
[picture p131: CAD file, 2021-01-04]
hardware/solidworks/house/Hex Spacer/Hex Spacer MF M3 L40mm.stp
5.00 x 5.77 x 46.0 mm
