tuannv-github/uwb-ips/hardware/solidworks/house/lightBulbHolder.SLDPRT

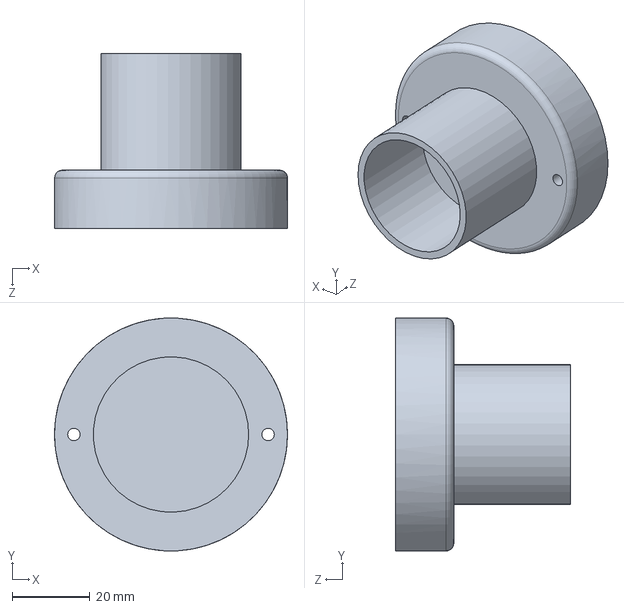
[picture p132: CAD file, 2021-01-04]
hardware/solidworks/house/lightBulbHolder.SLDPRT
60.0 x 60.0 x 45.0 mm
