tuannv-github/uwb-ips/hardware/solidworks/hook/mdek1001_rear_cover.STEP

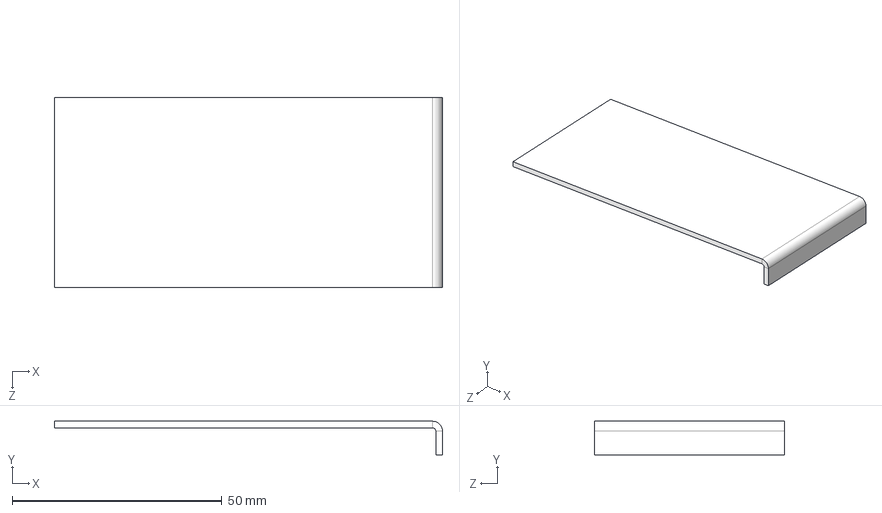
[picture p133: CAD file, 2021-01-04]
hardware/solidworks/hook/mdek1001_rear_cover.STEP
92.6 x 8.00 x 45.3 mm
