tuannv-github/uwb-ips/hardware/solidworks/house/frame_rtls_mid.SLDPRT

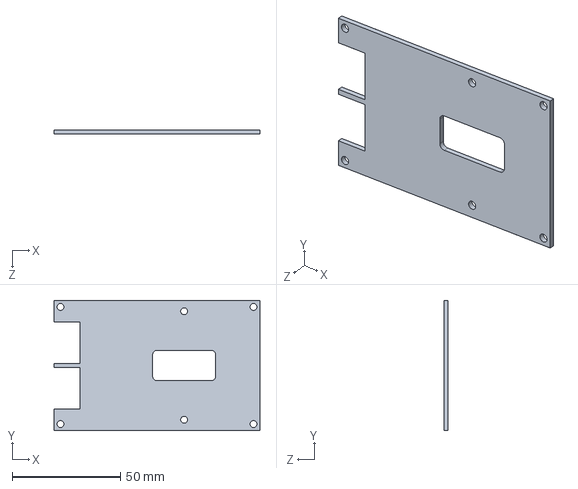
[picture p134: CAD file, 2021-01-04]
hardware/solidworks/house/frame_rtls_mid.SLDPRT
95.0 x 60.0 x 2.00 mm
