tuannv-github/uwb-ips/hardware/solidworks/house/Hex Spacer/Hex Spacer MF M3 L60mm.stp

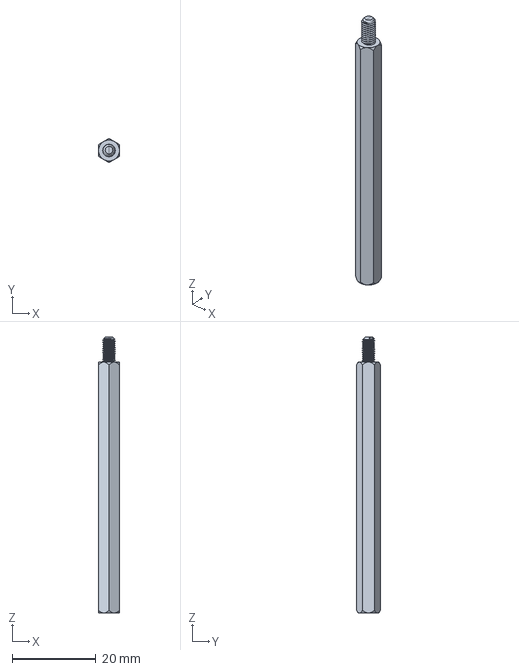
[picture p135: CAD file, 2021-01-04]
hardware/solidworks/house/Hex Spacer/Hex Spacer MF M3 L60mm.stp
5.00 x 5.77 x 66.0 mm
