tuannv-github/uwb-ips/hardware/solidworks/hook/Wall.SLDPRT

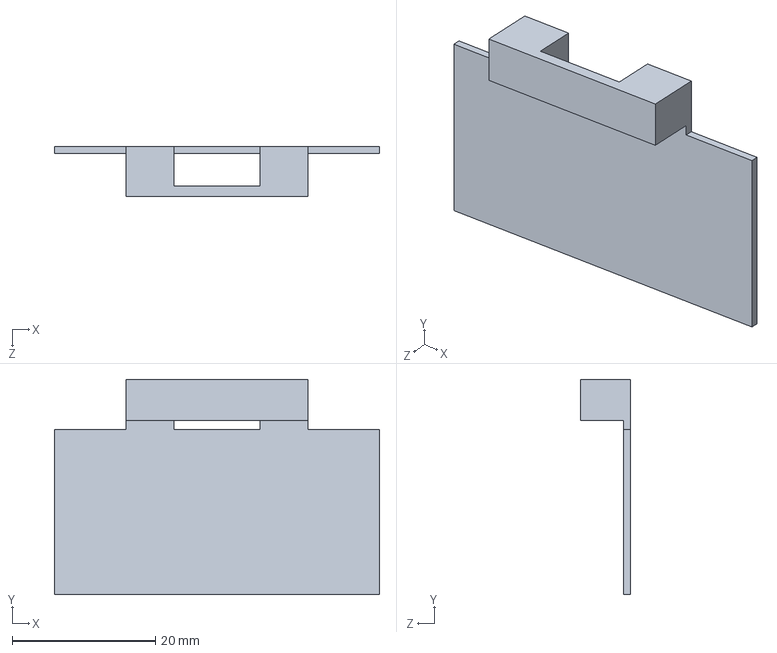
[picture p136: CAD file, 2021-01-04]
hardware/solidworks/hook/Wall.SLDPRT
45.3 x 30.0 x 7.00 mm
