tuannv-github/uwb-ips/hardware/solidworks/house/E27 400L.SLDPRT

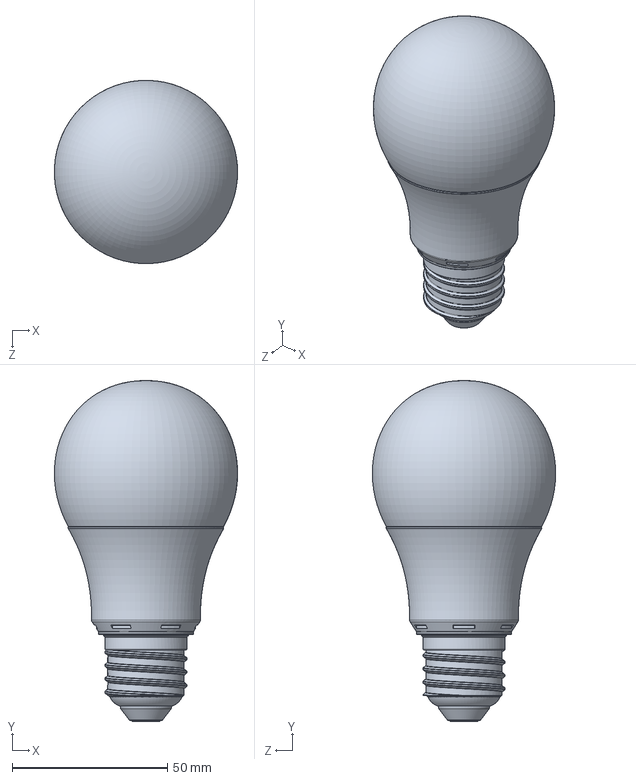
[picture p137: CAD file, 2021-01-04]
hardware/solidworks/house/E27 400L.SLDPRT
59.1 x 110.0 x 59.1 mm
