tuannv-github/uwb-ips/hardware/solidworks/house/Hex Spacer/Hex Spacer MF M3 L19mm.stp

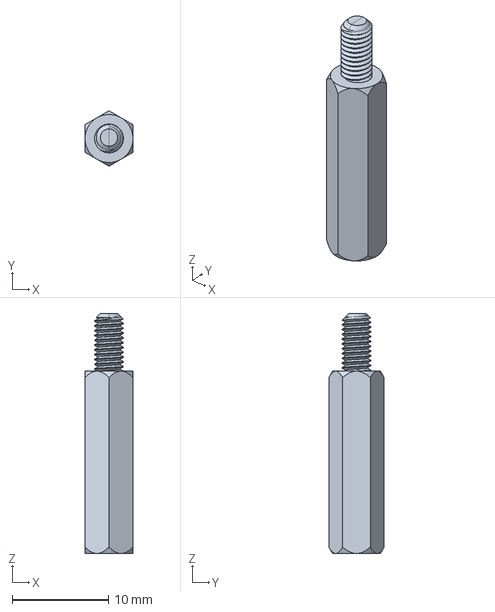
[picture p138: CAD file, 2021-01-04]
hardware/solidworks/house/Hex Spacer/Hex Spacer MF M3 L19mm.stp
5.00 x 5.77 x 25.0 mm
