tuannv-github/uwb-ips/hardware/solidworks/hook/mdek1001_housing.STEP

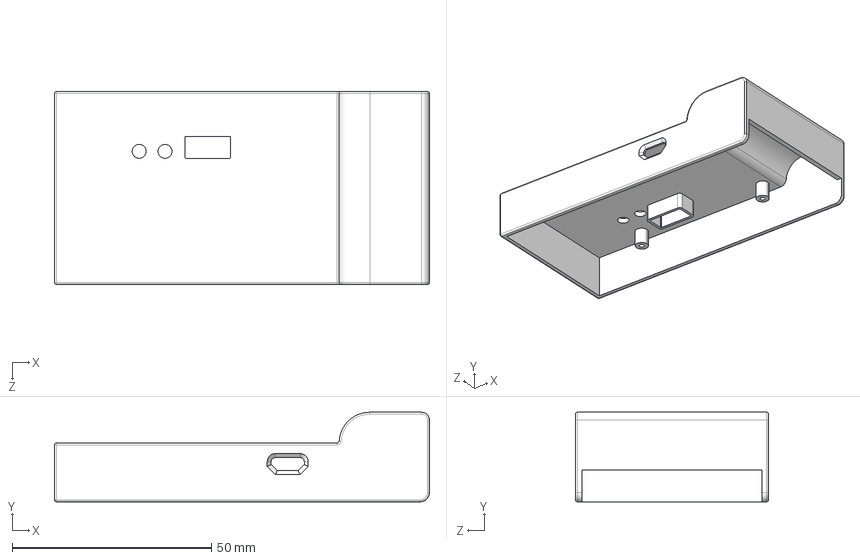
[picture p139: CAD file, 2021-01-04]
hardware/solidworks/hook/mdek1001_housing.STEP
94.2 x 22.5 x 48.5 mm
