tuannv-github/uwb-ips/hardware/solidworks/house/Hex Spacer/Hex Spacer MF M3 L17mm.stp

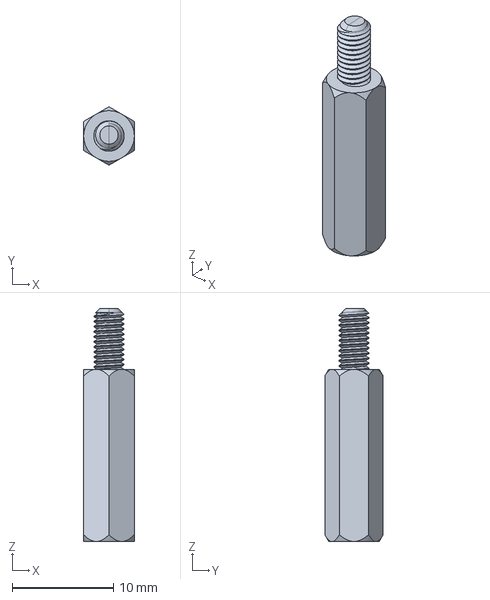
[picture p140: CAD file, 2021-01-04]
hardware/solidworks/house/Hex Spacer/Hex Spacer MF M3 L17mm.stp
5.00 x 5.77 x 23.0 mm
