tuannv-github/uwb-ips/(list of files, cad)

Other CAD files:
hardware/solidworks/hook/Wall.STL
hardware/solidworks/hook/screw_iso_1481-st_2_2x4_5-c.STEP
