tuannv-github/uwb-ips/reports/06_result/img/arena_04.jpg

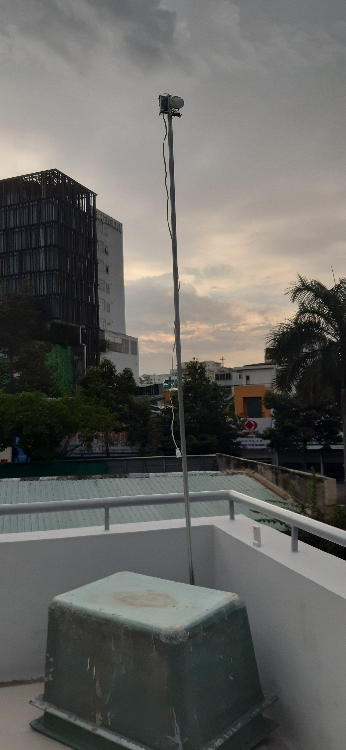
reports/06_result/img/arena_04.jpg
