tuannv-github/uwb-ips/reports/06_result/img/arena_05.jpg

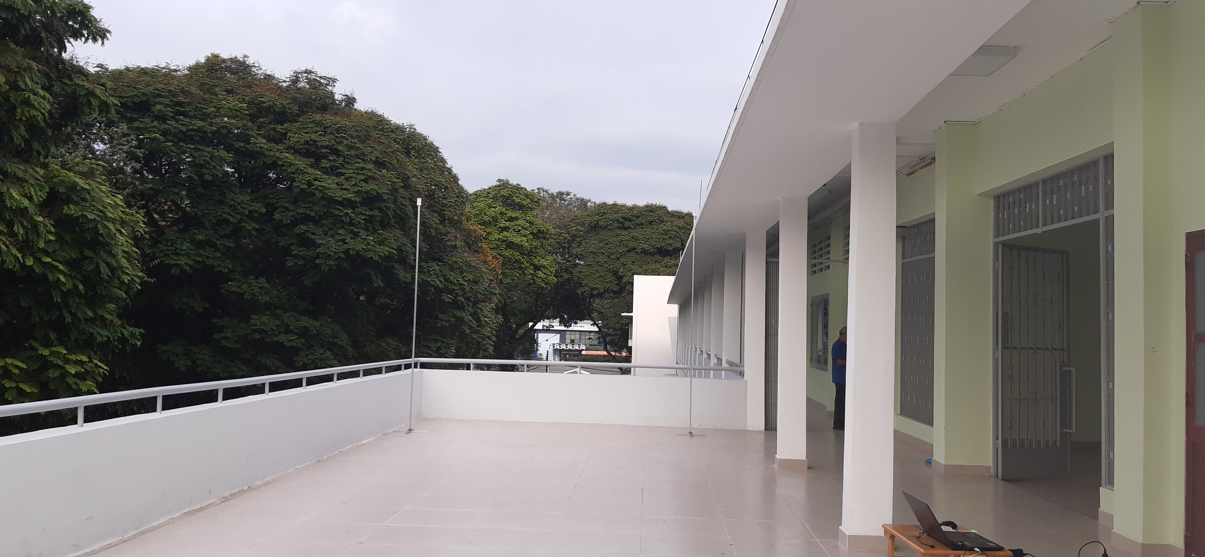
reports/06_result/img/arena_05.jpg
