tuannv-github/uwb-ips/reports/06_result/img/arena_06.jpg

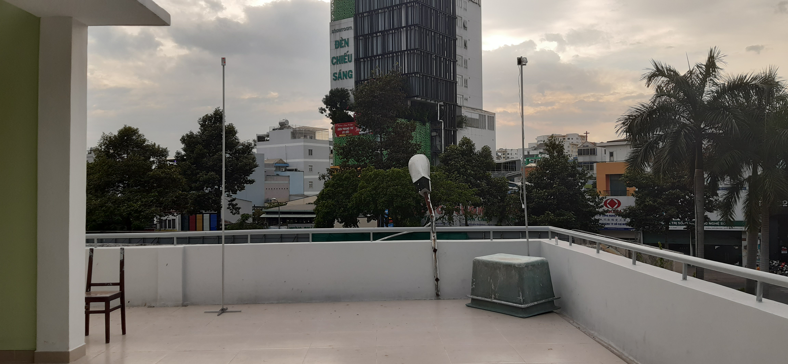
reports/06_result/img/arena_06.jpg
