tuannv-github/uwb-ips/reports/06_result/img/result_remote_control_off.png

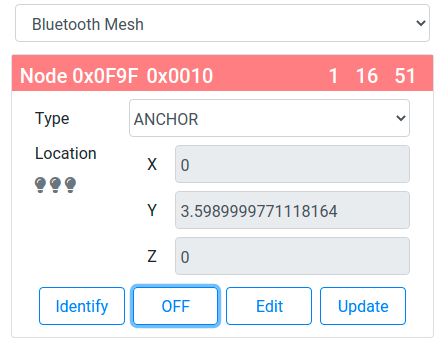
reports/06_result/img/result_remote_control_off.png
