tuannv-github/uwb-ips/reports/docs/RTLS-2021-01-09--13-27.PDF

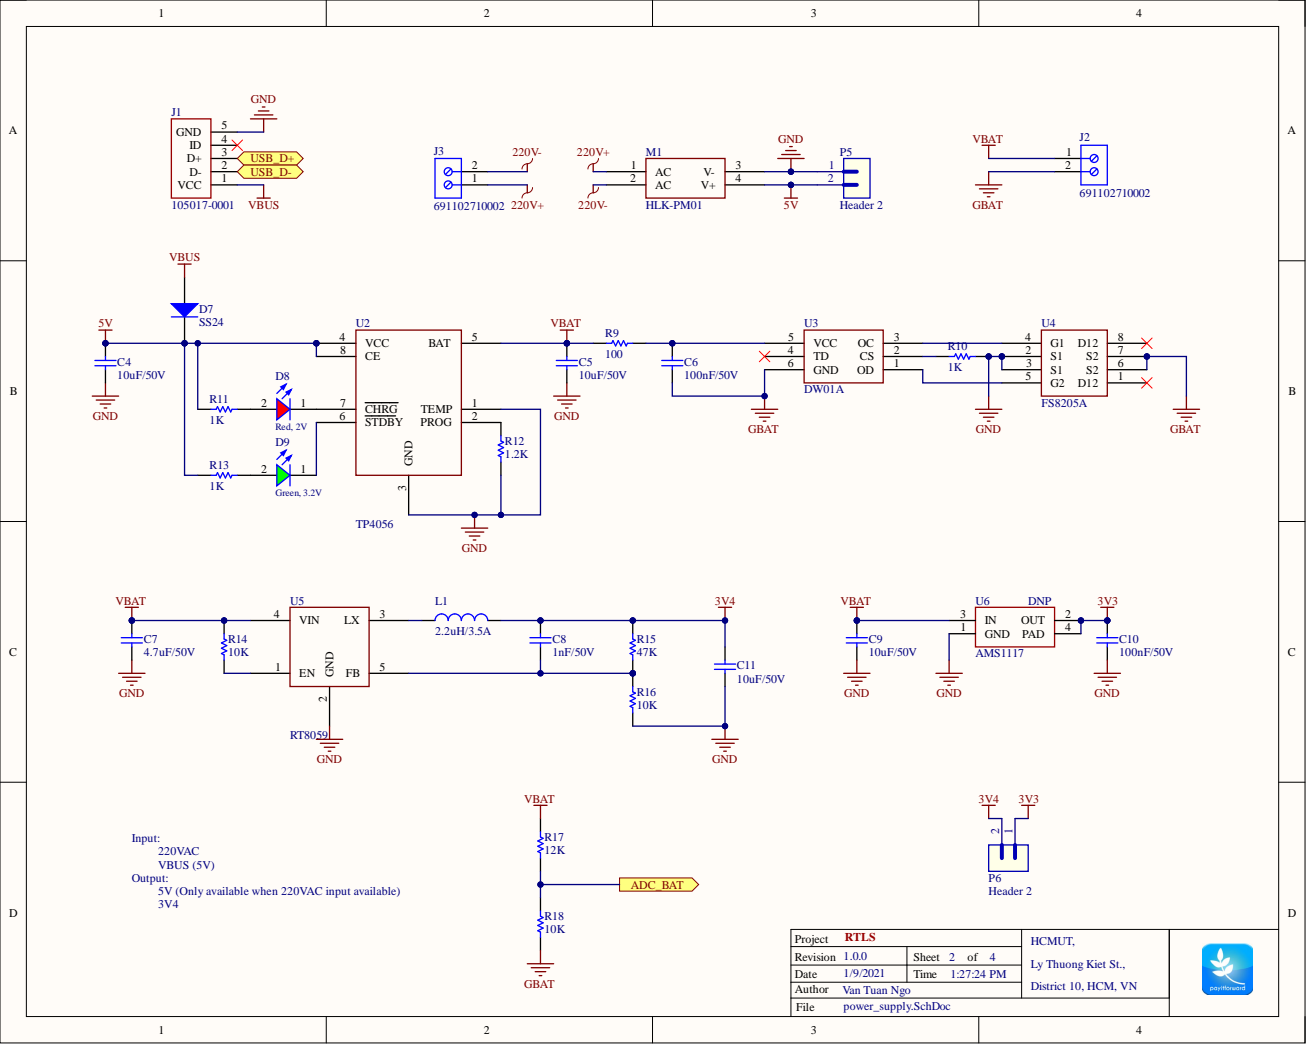
[picture p169: page 1]

Revision 1.0.0 | Sheet 2 of 4
Date 1/9/2021 | Time 1:27:24 PM

Ly Thuong Kiet St.,

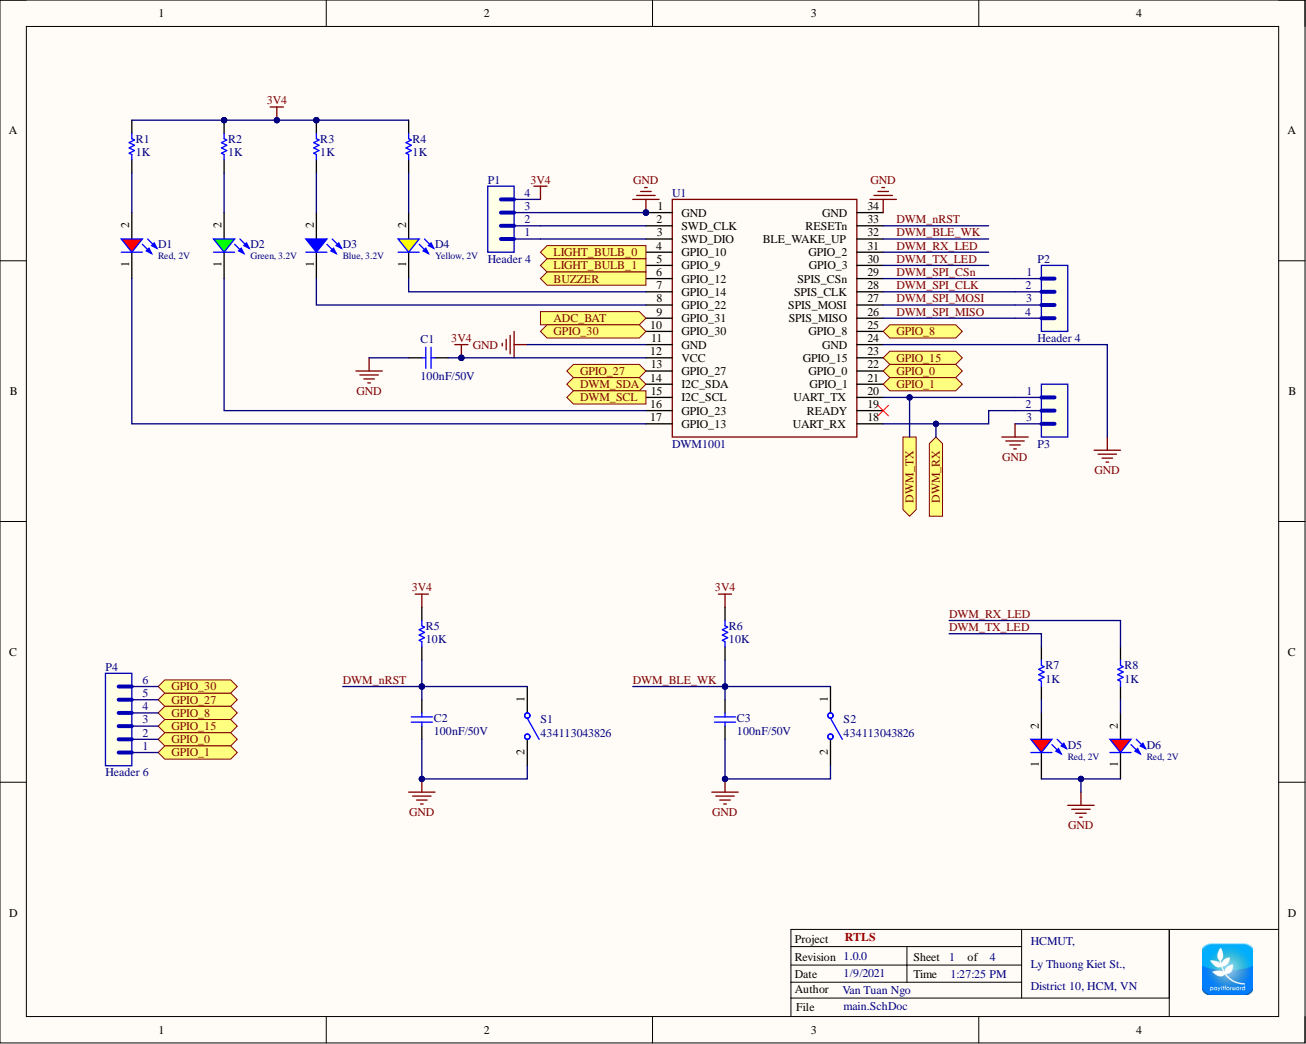
[picture p170: page 2]

RTLS 1.0.0 1/9/202 Rev i s i o n | Shee t o f

Dat e | Ti me : : 5 PM

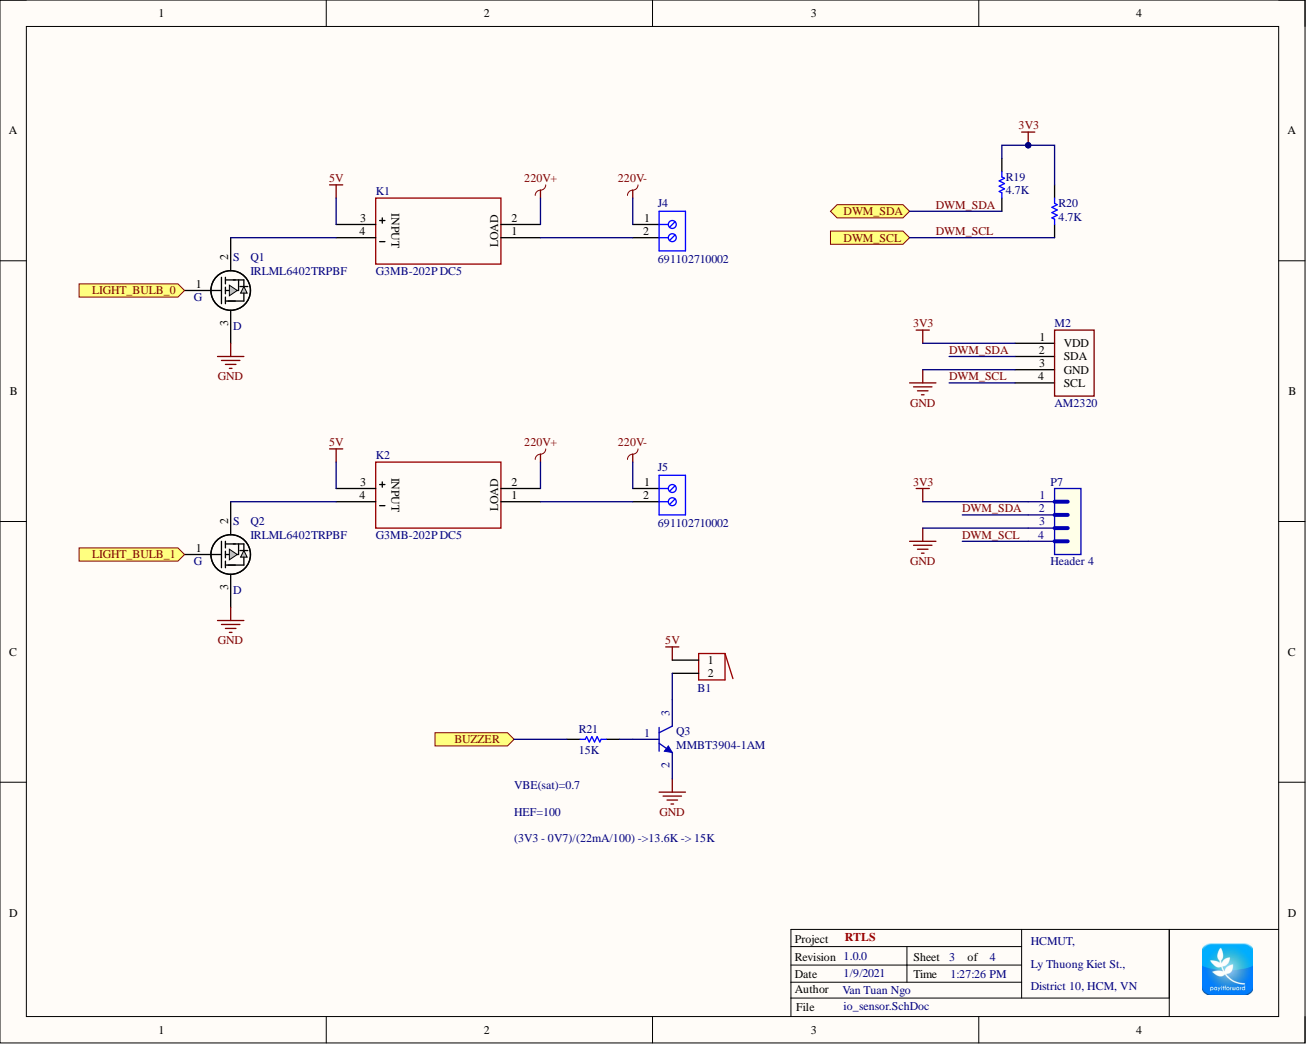
[picture p171: page 3]

Revision 1.0.0 | Sheet 3 of 4
Date 1/9/2021 | Time 1:27:26 PM

Ly Thuong Kiet St.,

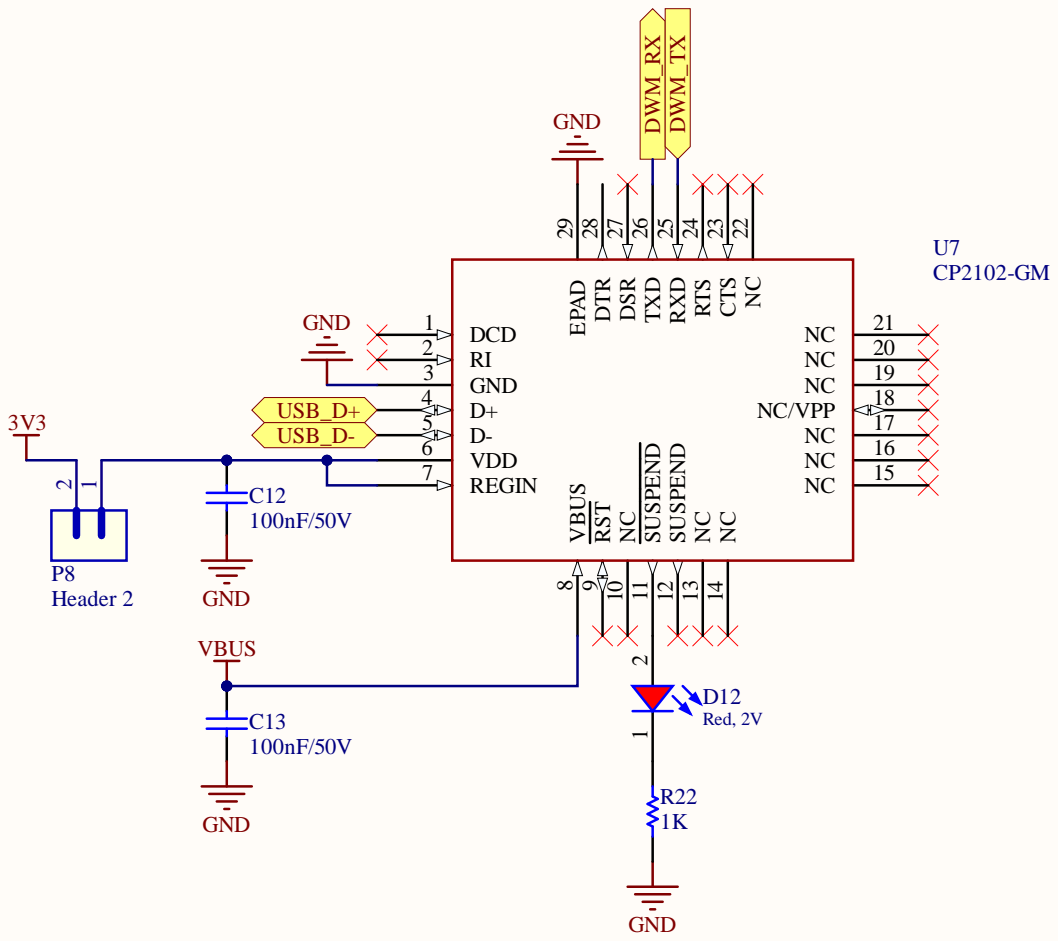
[picture p172: page 4]

NC 22 CTS 23 RTS 24 RXD 25 TXD 26 DSR 27 DTR 28 EPAD 29

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

Dat e | Ti me : : 7 PM

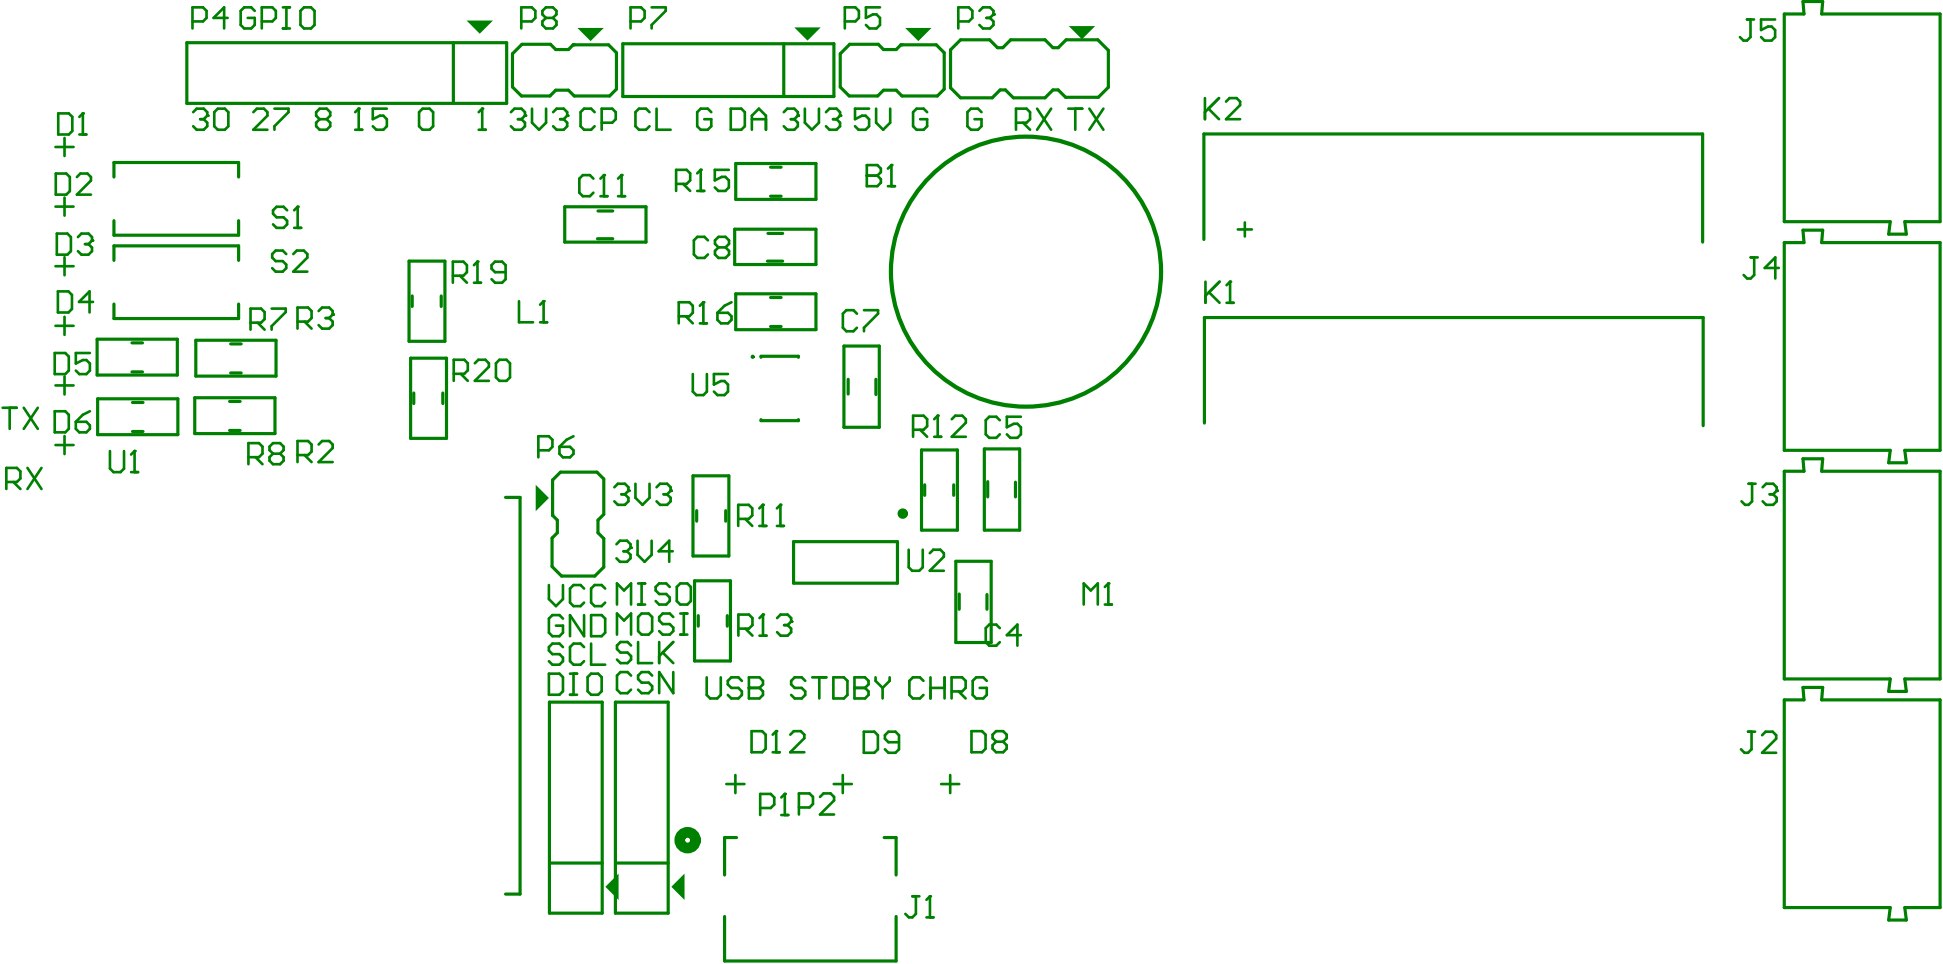
[picture p173: page 5]

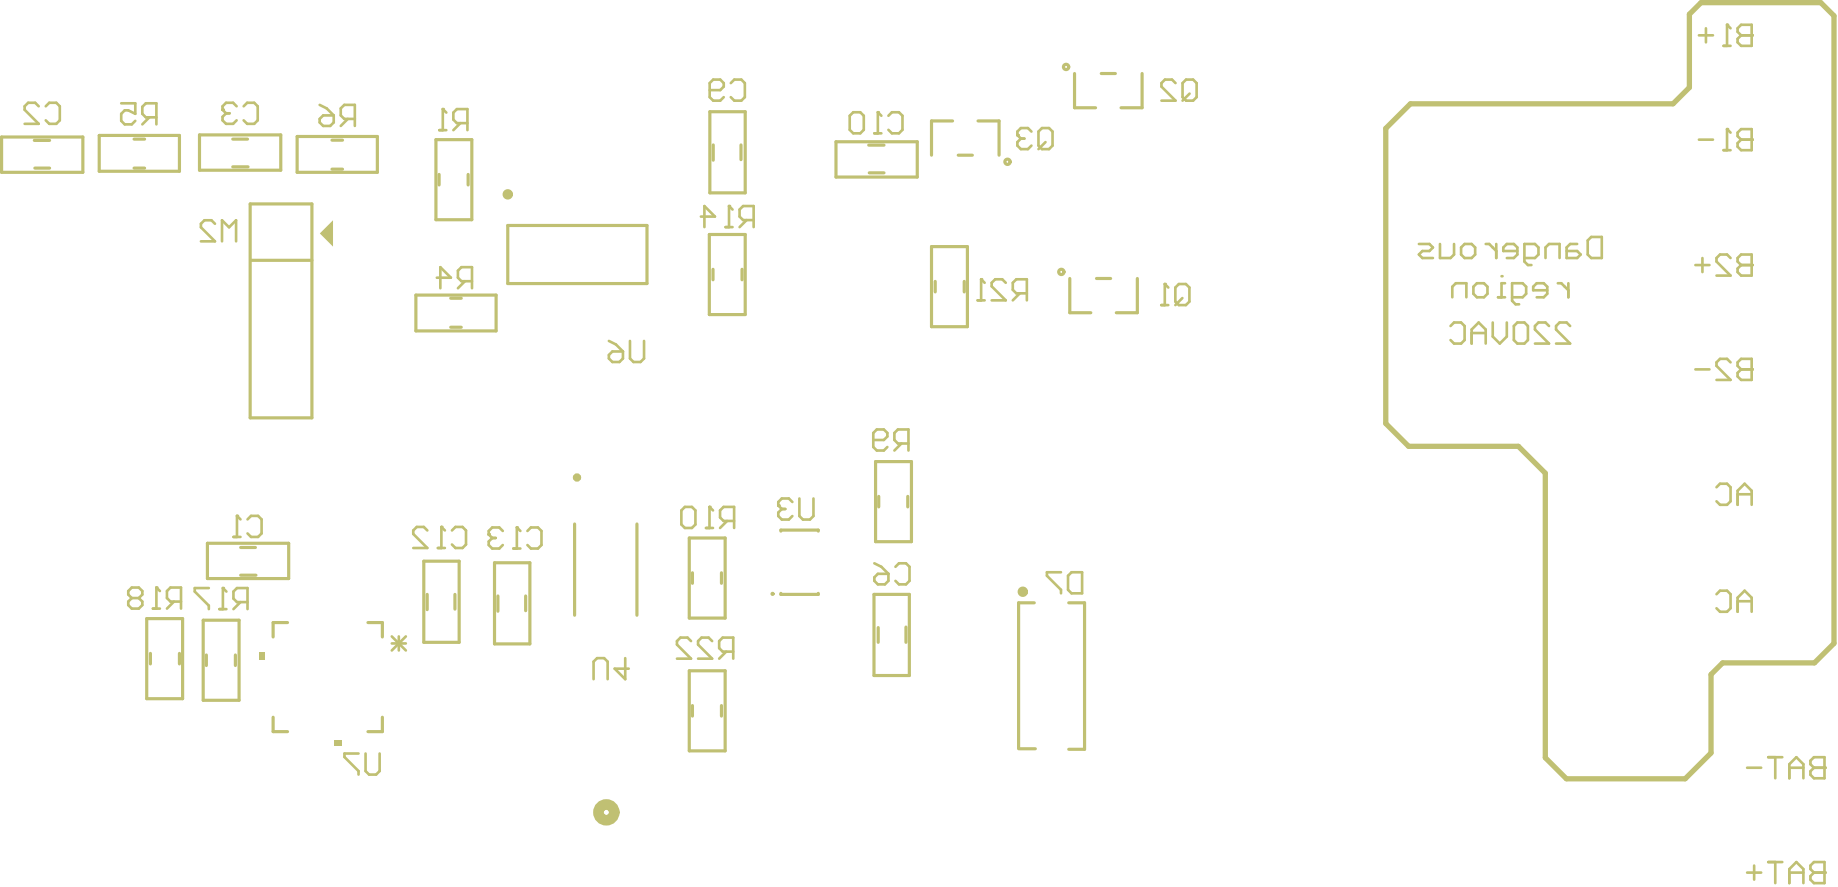
[picture p174: page 6]

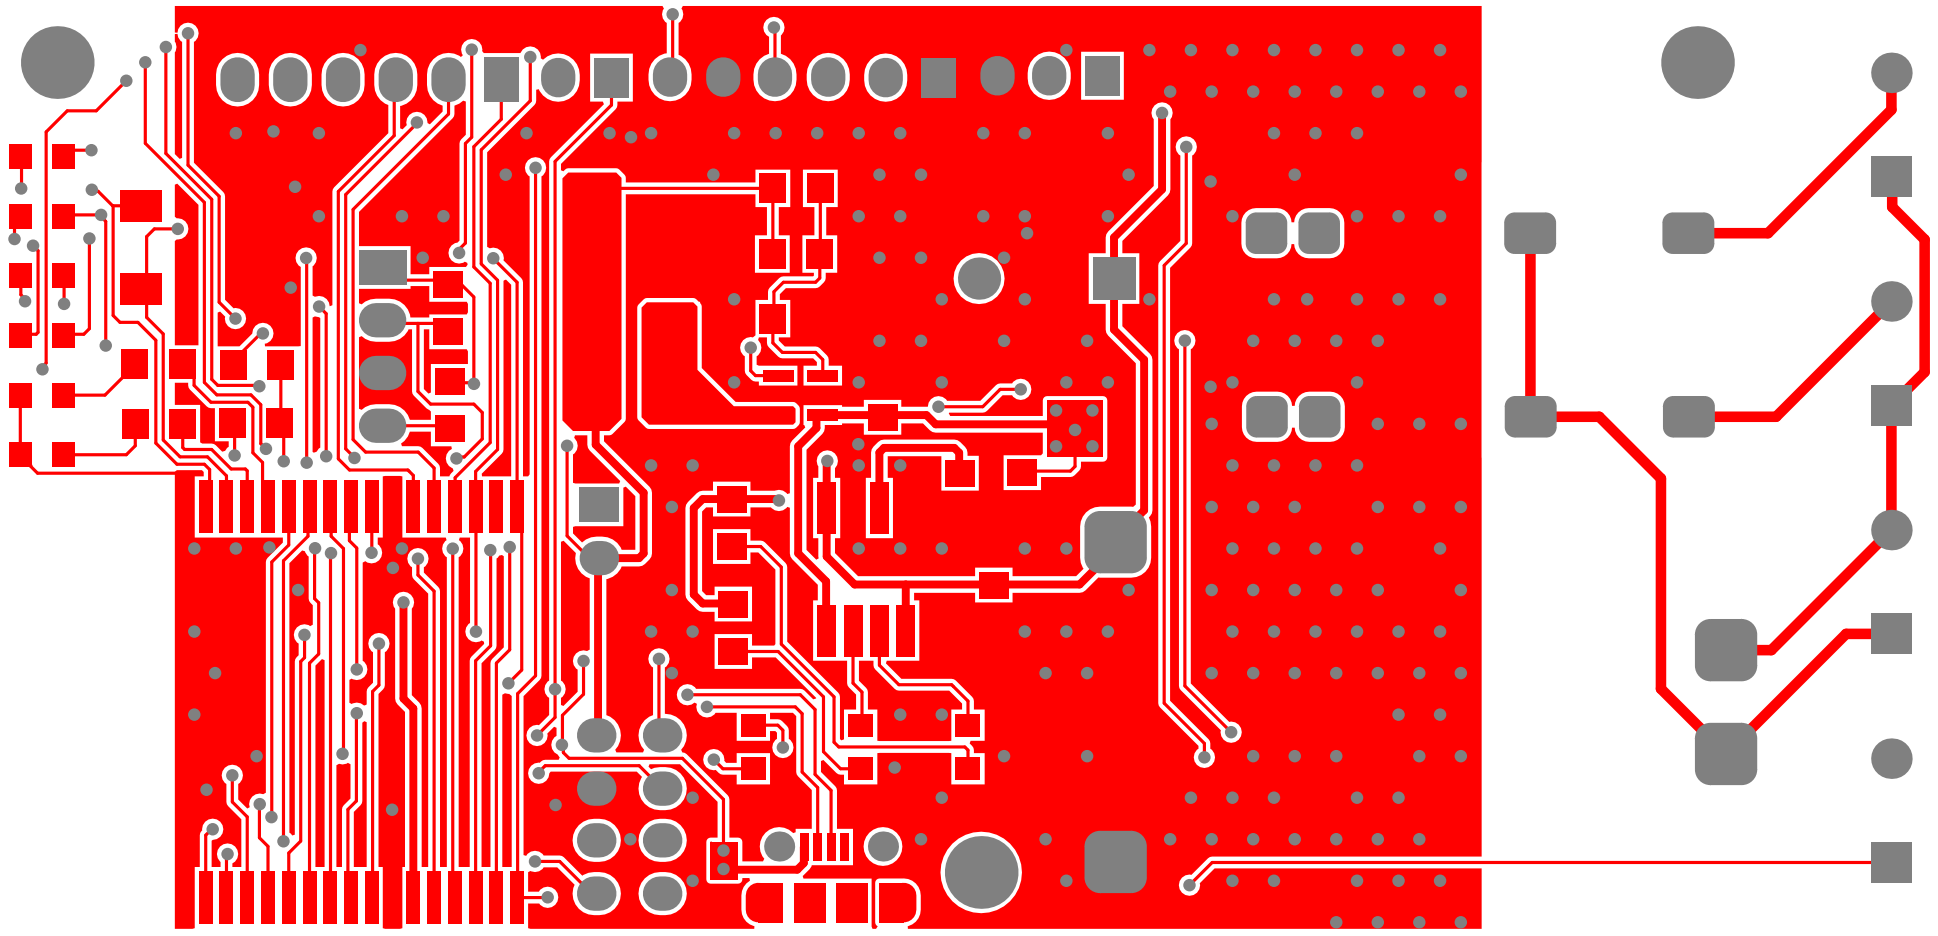
[picture p175: page 7]

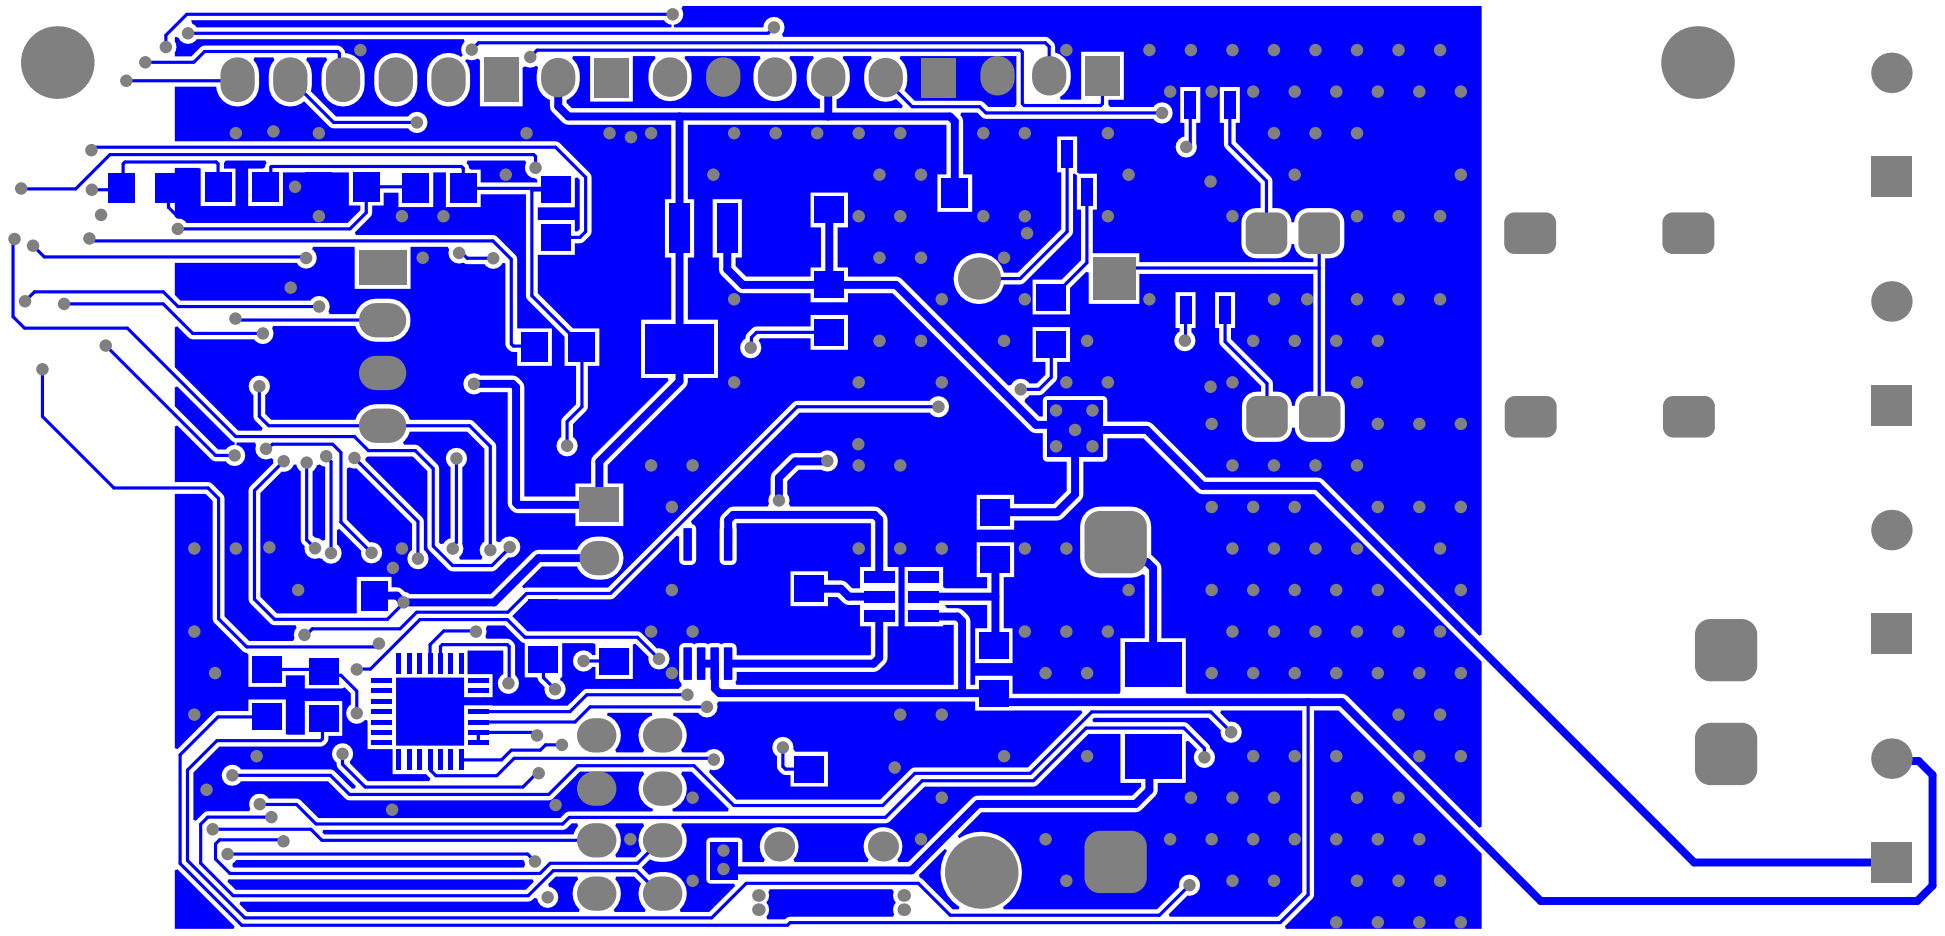
[picture p176: page 8]

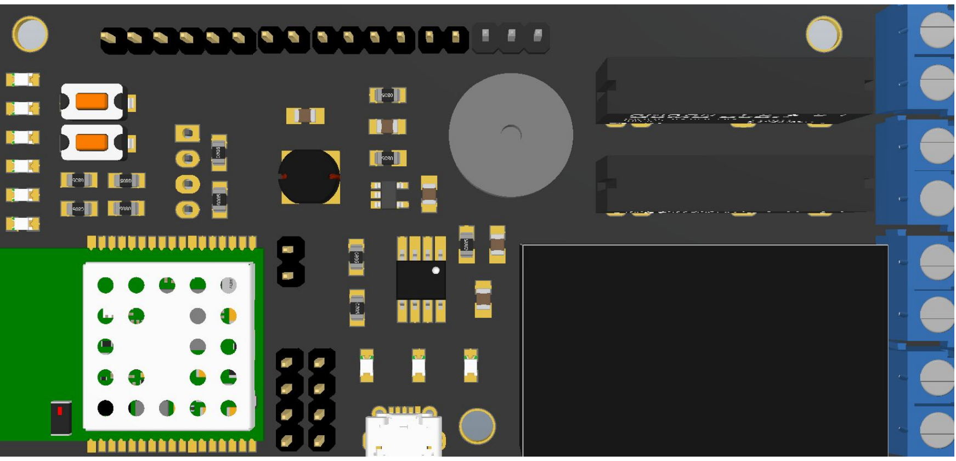
[picture p177: page 9]

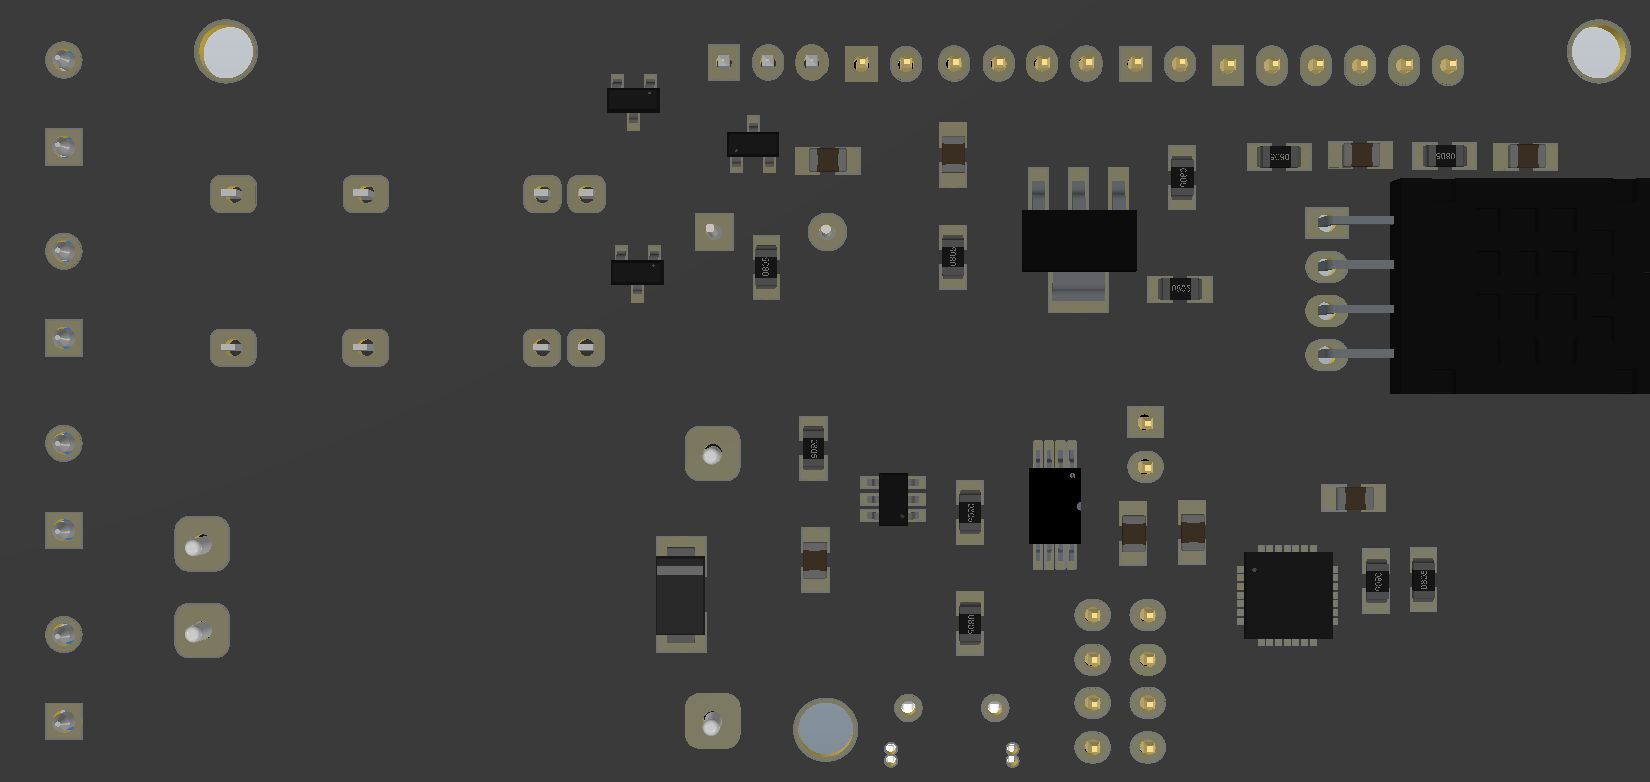
[picture p178: page 10]
