tuannv-github/uwb-ips/hardware/altium/docs/RTLS-2020-11-09--04-03.PDF

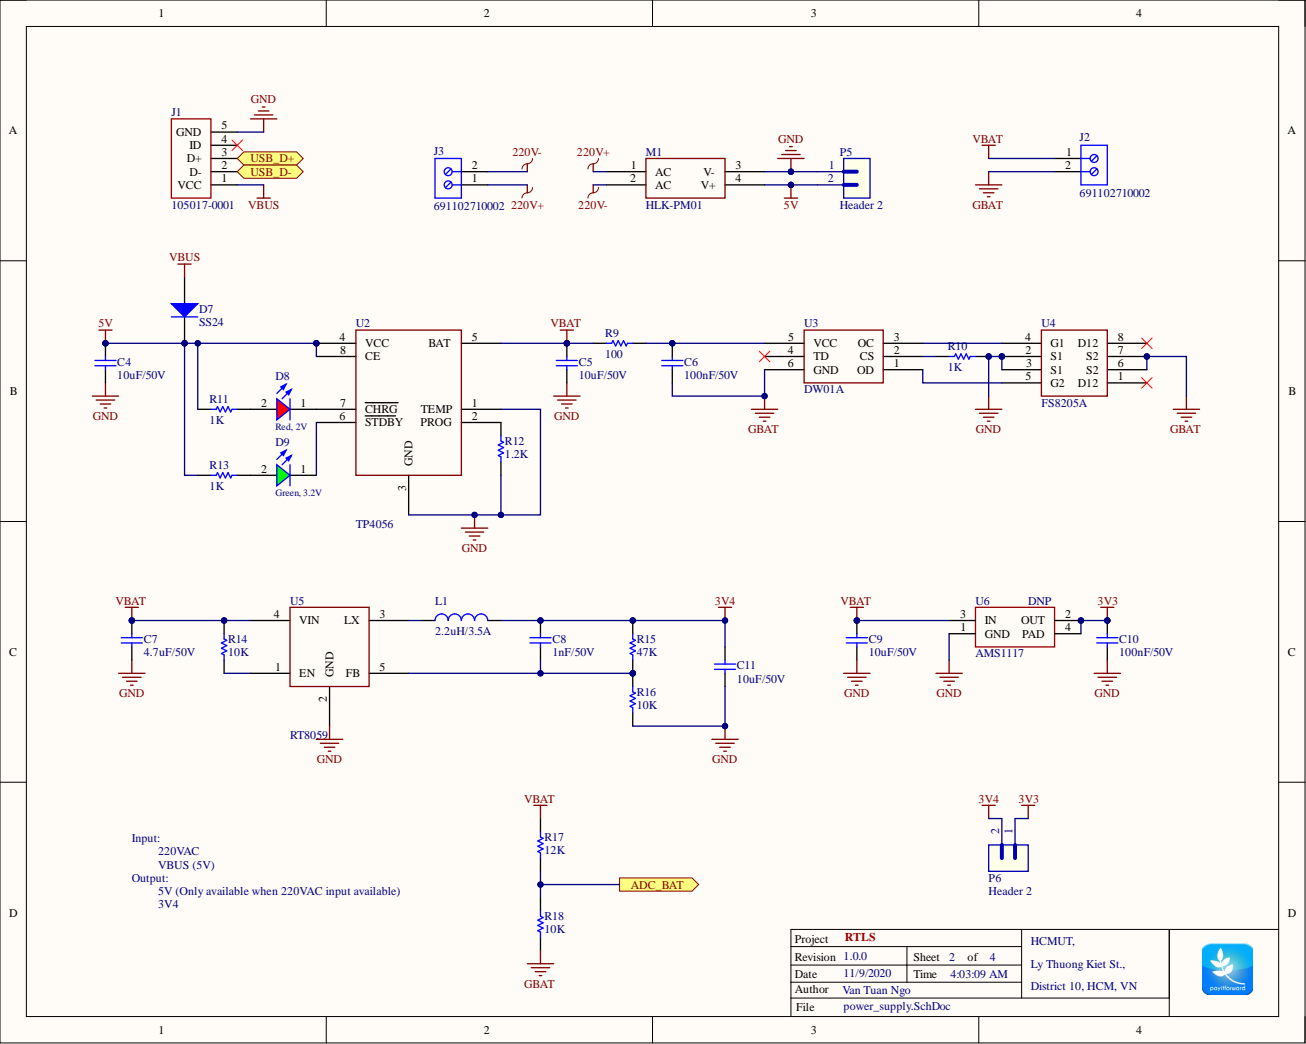
[picture p179: page 1]

Revision 1.0.0 | Sheet 2 of 4
Date 11/9/2020 | Time 4:03:09 AM

Ly Thuong Kiet St.,

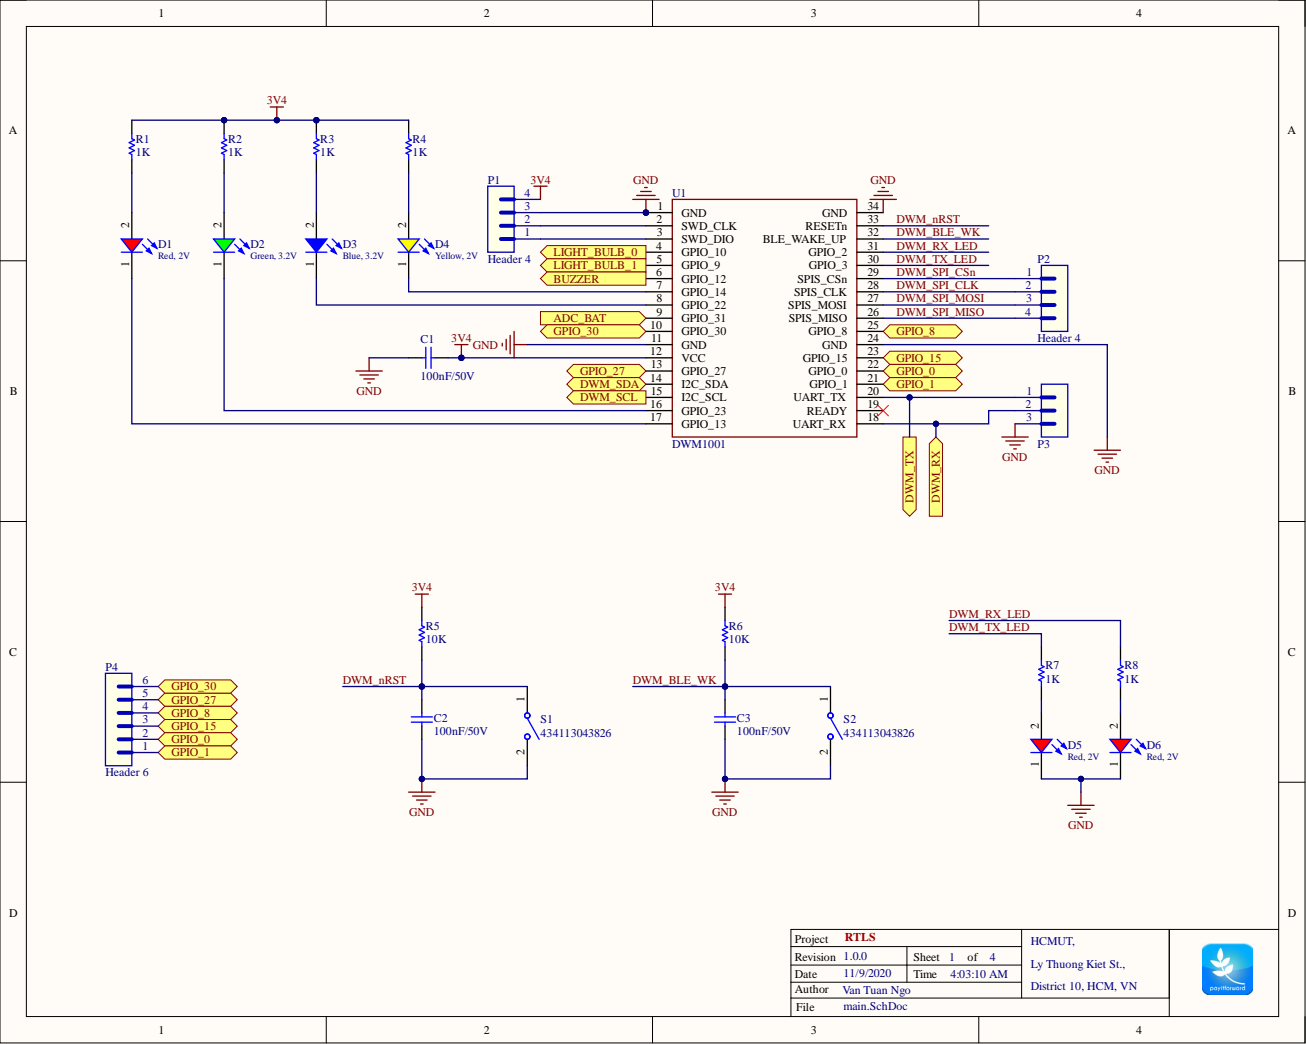
[picture p180: page 2]

RTLS 1.0.0 11/9/20 Rev i s i o n | Shee t o f

Dat e | Ti me : : A M

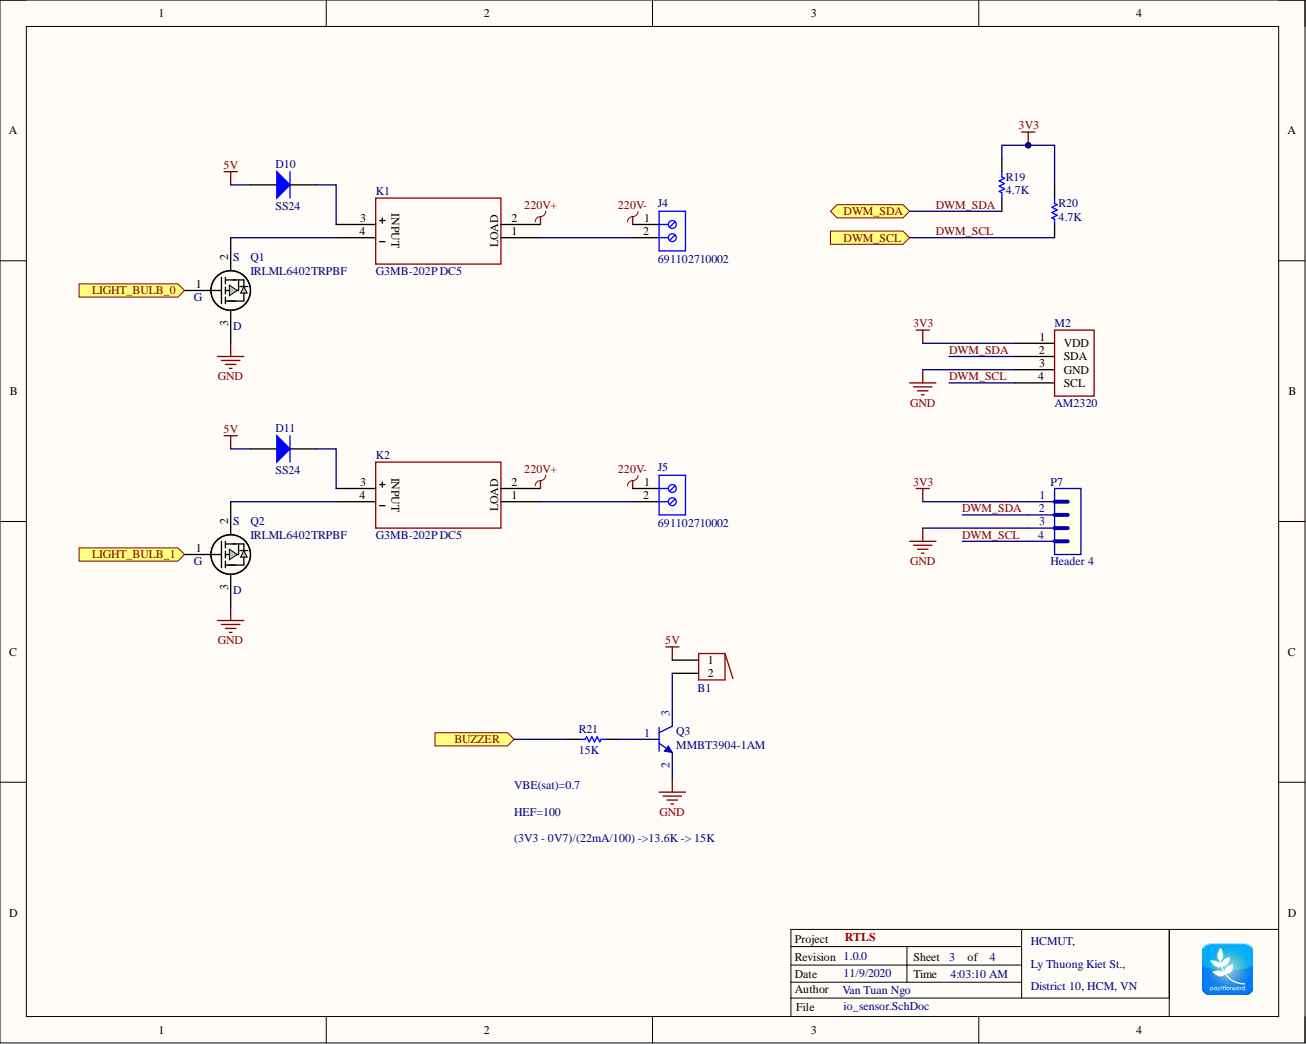
[picture p181: page 3]

Revision 1.0.0 | Sheet 3 of 4
Date 11/9/2020 | Time 4:03:10 AM

Ly Thuong Kiet St.,


NC 22 CTS 23 RTS 24 RXD 25 TXD 26 DSR 27 DTR 28 EPAD 29

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

Dat e | Ti me : : A M


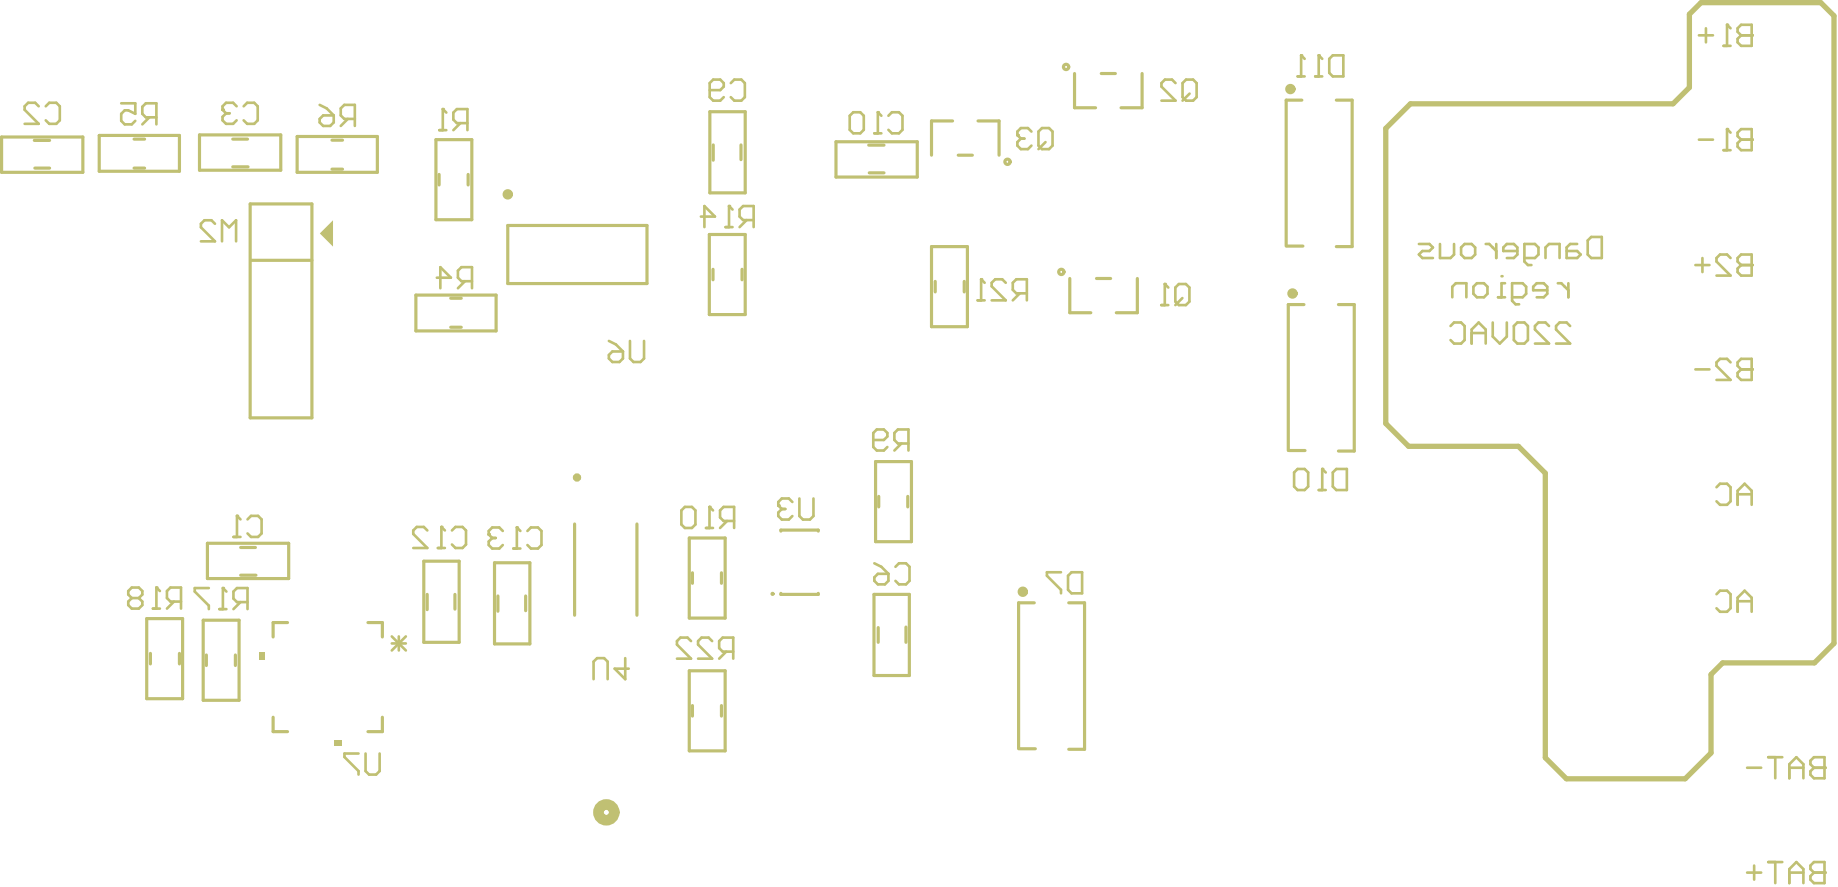
[picture p182: page 6]

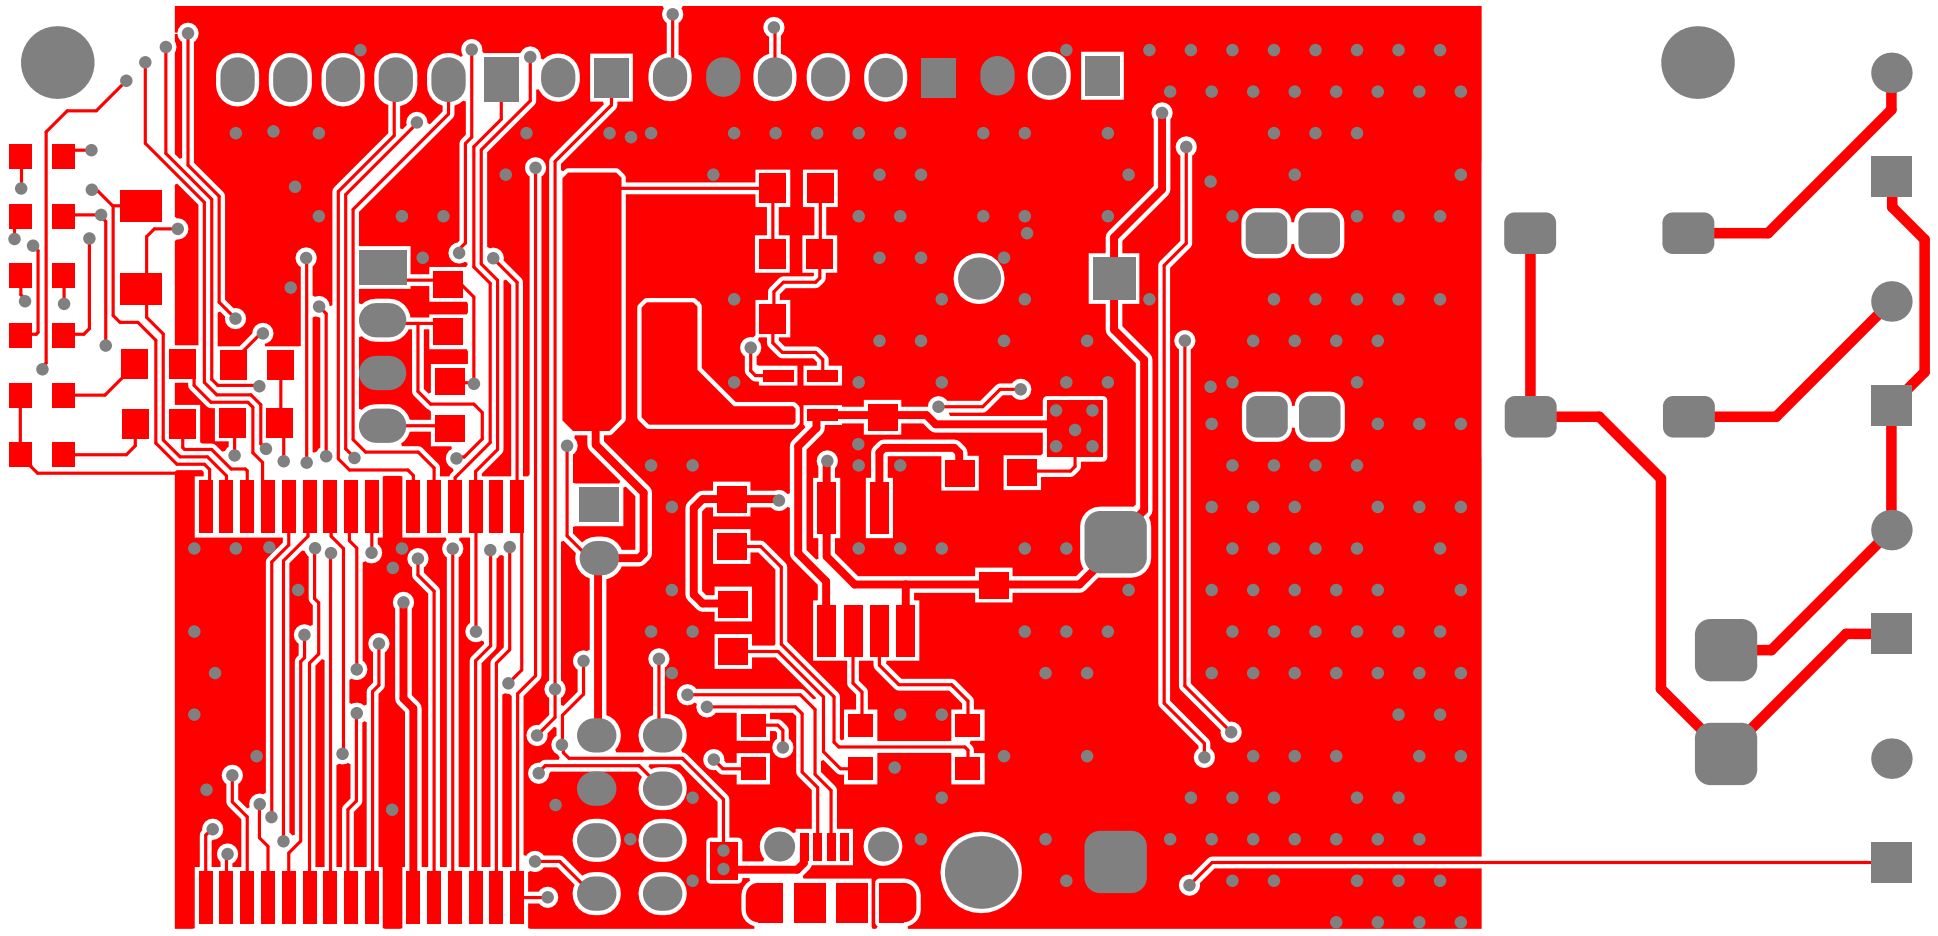
[picture p183: page 7]

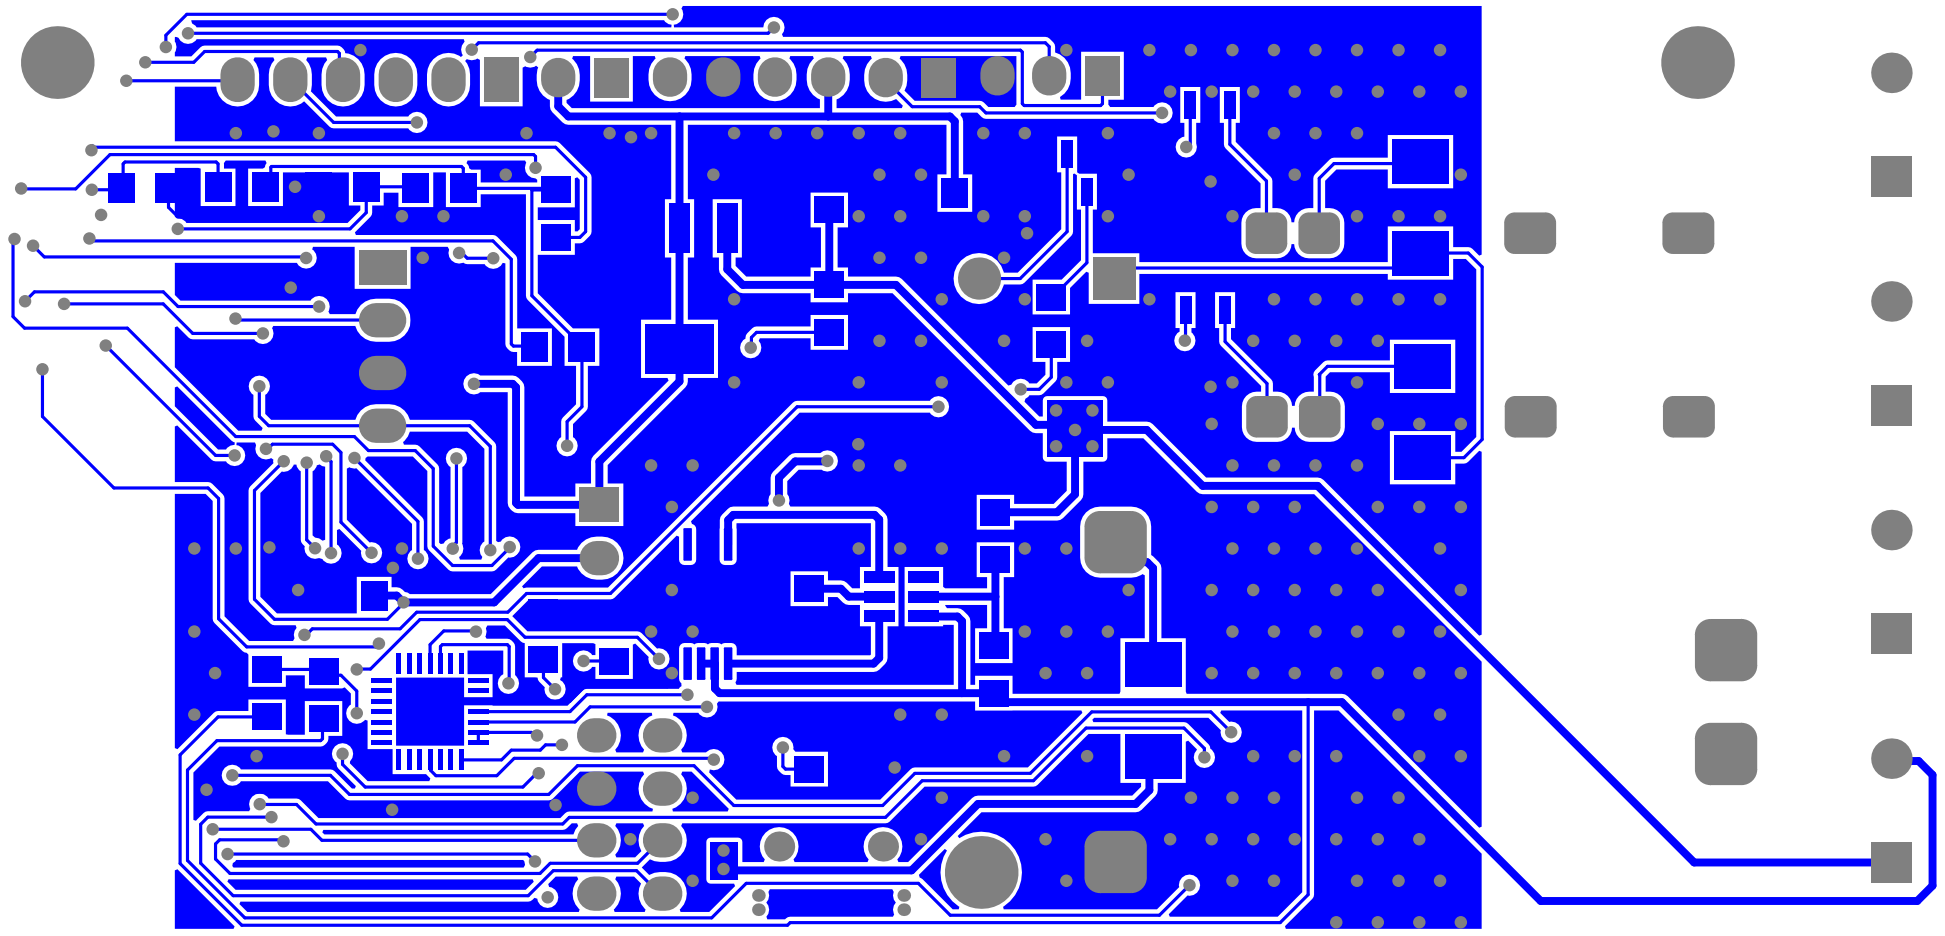
[picture p184: page 8]

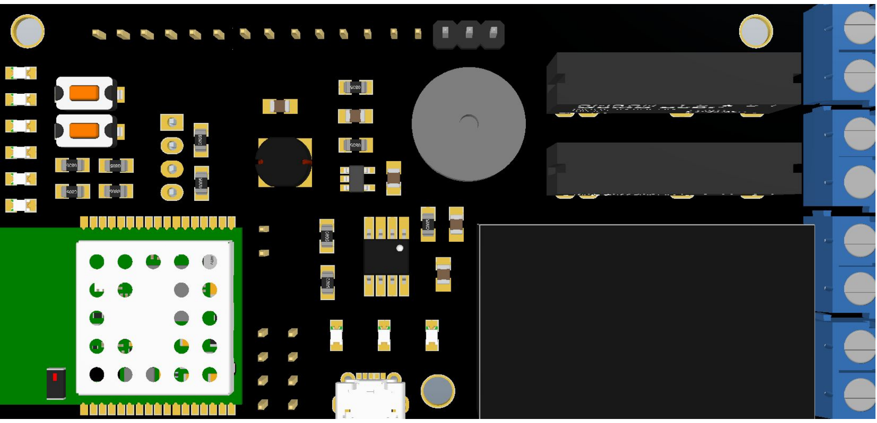
[picture p185: page 9]

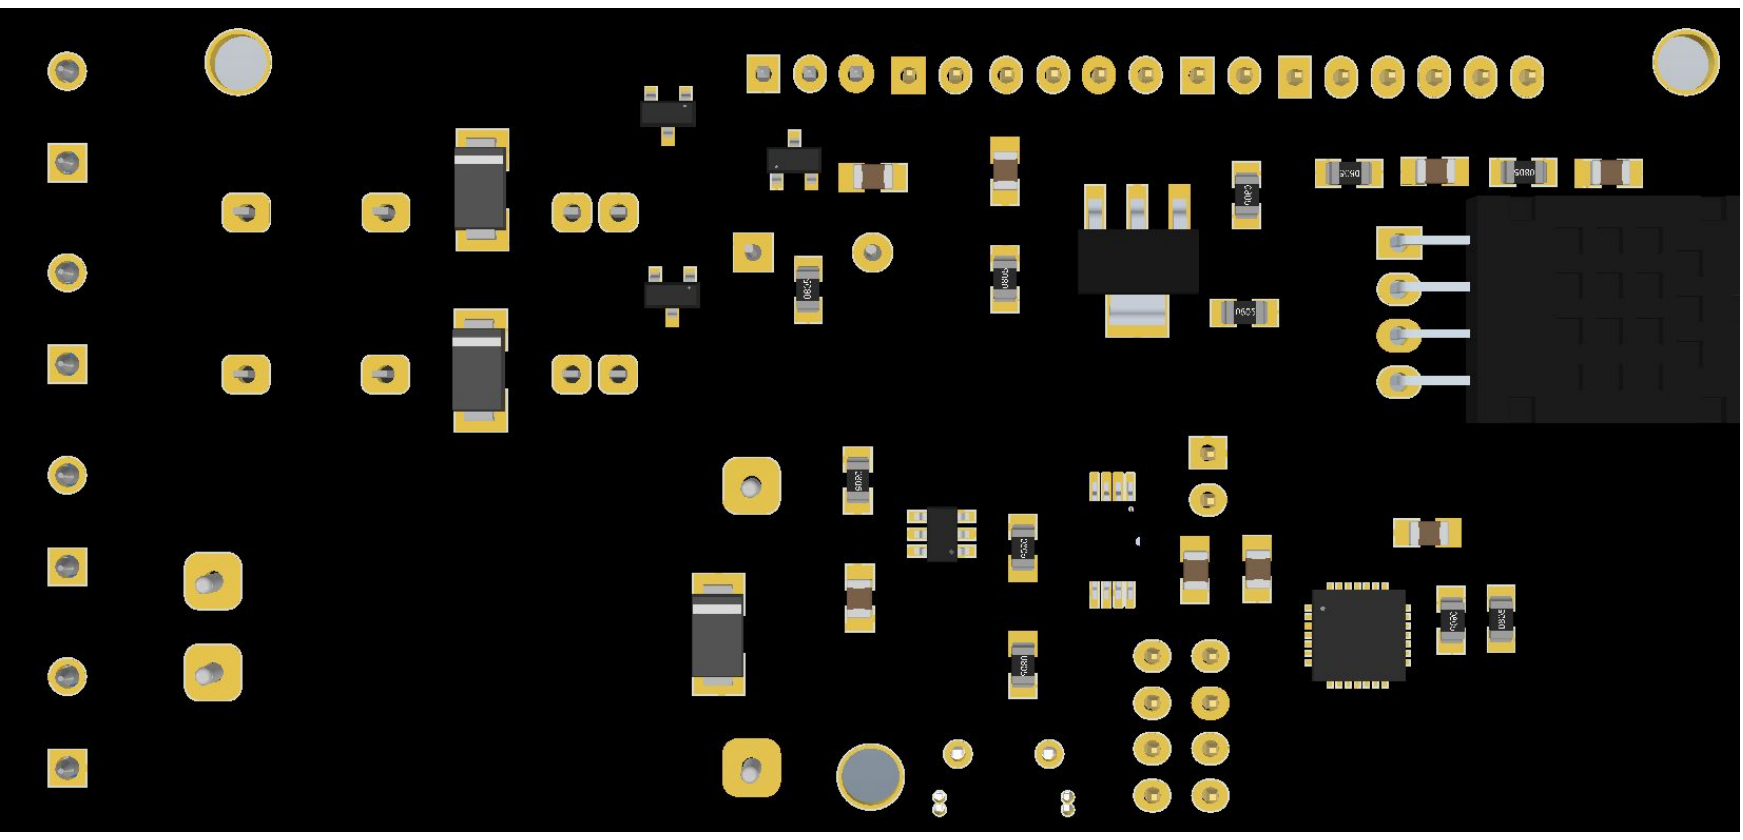
[picture p186: page 10]
