tuannv-github/uwb-ips/(list of files, drawings)

Other design files:
hardware/altium/io_sensor.SchDoc
hardware/altium/main.SchDoc
hardware/altium/power_supply.SchDoc
hardware/altium/rtls.PcbDoc
hardware/altium/rtls.PcbLib
hardware/altium/rtls.PrjPcb
hardware/altium/rtls.SchLib
hardware/altium/serial.SchDoc
hardware/rtls_tag/main.SchDoc
hardware/rtls_tag/power_supply.SchDoc
hardware/rtls_tag/rtls_tag.PrjPcb
hardware/rtls_tag/serial.SchDoc
hardware/rtls_tag/wifi.SchDoc
