tuannv-github/uwb-ips/software/linux/gateway/config.py

CMD_TOPIC = "topic_cmd"
EVT_TOPIC = "topic_evt"

# SERIAL_PORT = "/dev/pts/3"
# SERIAL_BAUD = 115200

SERIAL_PORT = "/dev/ttyGateway"
SERIAL_BAUD = 115200

SERIAL_TAG_PORT = "/dev/ttyTag"
SERIAL_TAG_BAUD = 115200

# SERIAL_TAG_PORT = "/dev/pts/5"
# SERIAL_TAG_BAUD = 115200

# SERIAL_PORT = "/dev/ttyRelay"
# SERIAL_BAUD = 115200

SERIAL_PORT_SIM = "/dev/pts/4"
SERIAL_BAUD_SIM = 115200
