tuannv-github/uwb-ips/(commit log)

2020-10-22 add some hw
    [Relay - 1912-12V-100A.stp, Relay - G3MB-202P.stp, Relay - JQC-3F(T73) - 5V.stp, Relay - SLA-05VDC-SL-C.stp, Relay - SRA-05VDC-CL.stp, Relay - SRA-12VDC-CL.stp, Relay - SRD-03VDC-SL-C.stp, Relay -HK4100F-DC3V-SHG.stp]
2020-10-26 change print uint32_t type
2020-10-26 remove uwb_ccp printf, add ccp change role
2020-10-26 rtls_tdma slot callback has been called
2020-10-31 add some components
    [io_sensor.SchDoc, main.SchDoc, power_supply.SchDoc, rtls.PcbDoc, rtls.PrjPcb]
2020-10-31 battery charger: checked
    [power_supply.SchDoc]
2020-11-01 Shematic may be done
    [Relay - 1912-12V-100A.stp, Relay - G3MB-202P.stp, Relay - JQC-3F(T73) - 5V.stp, Relay - SLA-05VDC-SL-C.stp, Relay - SRA-05VDC-CL.stp, Relay - SRA-12VDC-CL.stp, Relay - SRD-03VDC-SL-C.stp, Relay -HK4100F-DC3V-SHG.stp]
2020-11-03 add bat adc + buzzer
    [io_sensor.SchDoc, main.SchDoc, power_supply.SchDoc, rtls.PrjPcb, serial.SchDoc]
2020-11-04 able to ranging
    Todo: Add ranging slot asignment to rtls tdma
2020-11-04 pcb logic connection
    [io_sensor.SchDoc, main.SchDoc, power_supply.SchDoc, rtls.PcbDoc, serial.SchDoc]
2020-11-04 may want to change joint mechanism
2020-11-04 new joint schem: 2 nodes ok
2020-11-05 2 node bugs with dumpy slot response
2020-11-07 pcb route all
    [power_supply.SchDoc, rtls.PcbDoc, rtls.PrjPcb]
2020-11-07 hw 1 may ready to fabrication
    [io_sensor.SchDoc, main.SchDoc, power_supply.SchDoc, rtls.PrjPcb, serial.SchDoc]
2020-11-07 add stitching
    [rtls.PrjPcb]
2020-11-08 add button app
2020-11-09 root model led control with phone
2020-11-11 add identify button
2020-11-13 auto load firmware to all device and run rtt
2020-11-14 Able to send location over ble mesh to net with many bugs
    [ble_mesh.c, config.py, gateway.c, gateway.h, gateway.py, main.c]
2020-11-15 correct net to ble
    [gateway.c, model_gateway.c]
2020-11-15 remove error flag + correct net to ble msg type
    [model_gateway.c]
2020-11-16 43 publish message bug
    [gateway.c, model_gateway.c, syscfg.yml]
2020-11-17 able to stat periodic publish error
    [model_root.c]
2020-11-18 able to request the RANGE slot for the first time only
2020-11-19 able to request a range slot, but it never timeout
    Todo: timeout in range slot
2020-11-19 fix dummy slot map of anchor table
2020-11-19 able to range with master
    - only able to range when network has no more than 2 anchor
    - ranging is unstable
    [syscfg.yml]
2020-11-21 range in my slot only
2020-11-21 update wireshark app --> it is buggy now ;)
    [main.c, syscfg.yml]
2020-11-23 add wall stick hook
    [Wall.SLDPRT, Wall.STL, bat_RCR123A.STEP, mdek1001_housing.STEP, mdek1001_rear_cover.STEP, rtls.PrjPcb, screw_iso_1481-st_2_2x4_5-c.STEP]
2020-11-24 correct tag print format
2020-11-24 add relay node but it does not work
    [main.c, syscfg.yml]
2020-11-25 add relay role to gateway
2020-11-25 add docs
    [rtls.PrjPcb]
2020-11-25 message relayed
2020-11-25 remove relay app: gateway are now relay too
2020-11-27 not enough RAM for put gateway and relay in the same SOC
2020-11-30 build 3d model for anchor
    [E27 400L.SLDPRT, Hex Spacer MF M3 L10mm.stp, Hex Spacer MF M3 L11mm.stp, Hex Spacer MF M3 L12mm.stp, Hex Spacer MF M3 L13mm.stp, Hex Spacer MF M3 L14mm.stp, Hex Spacer MF M3 L15mm.stp, Hex Spacer MF M3 L16mm.stp]
2020-12-01 update rtls 3d model
    [frame_rtls.DXF, frame_rtls_mid.DXF, frame_rtls_mid.SLDPRT, frame_rtls_top.DXF, lightBulbHolder.SLDPRT, rocker_switch.SLDPRT]
2020-12-04 rotate rtls board
    [frame_rtls.DXF, frame_rtls_mid.DXF, frame_rtls_mid.SLDPRT, frame_rtls_top.DXF]
2020-12-04 add tag slot timeout
2020-12-04 +tag timeout +tag see new anchor +anchor see new anchor
    +tag power on before any anchor
2020-12-04 add led to indicate ccp role
2020-12-05 pin 14, 22 is used for master slave indication in rtls_ccp
2020-12-05 add light bulb button
2020-12-08 update wireshark app
2020-12-11 anchor are MASTER + SLAVE + RELAY
2020-12-11 ccp master role collision auto recovery
    [syscfg.yml]
2020-12-13 add symmetric hook
    [frame_rtls.DXF, frame_rtls_mid.DXF, frame_rtls_mid.SLDPRT, frame_rtls_top.DXF]
2020-12-13 add hardware appendix
    [E27 400L.SLDPRT, rocker_switch.SLDPRT]
2020-12-14 add anchor + print rssi
2020-12-17 add ccp slave flow chart
2020-12-18 add twr flow diagram
2020-12-18 add tdma slot msg
2020-12-18 add nrf52840 relay and boot build
2020-12-20 increase RX_SEG_MSG_COUNT
    Fix warning: No free slots for new incoming segmented messages
    [syscfg.yml]
2020-12-21 add led status
2020-12-21 always repeat master timer
2020-12-24 add twr frame
2020-12-25 add rtls_tag
    [main.SchDoc, power_supply.SchDoc, rtls_tag.PrjPcb, serial.SchDoc, wifi.SchDoc]
2020-12-27 add buck circuit report
2020-12-30 do not re-attemp to slot
2020-12-31 update buck circuit description
2021-01-01 fix hook hold size
    fix hook hold size
    [frame_rtls.DXF]
2021-01-01 ignore corel folder
    [frame_rtls.DXF, frame_rtls_mid.DXF, frame_rtls_top.DXF]
2021-01-02 fix for finding 4 nearest anchor
    [syscfg.yml]
2021-01-03 tag ask if it slot is occupied + only anchor can joint without permission
2021-01-05 use UART interface
2021-01-05 auto connect to Wi-Fi beagle bone green wireless
2021-01-09 remove diodes
    [io_sensor.SchDoc, rtls.PrjPcb]
2021-01-09 upper-case for chapter name
2021-01-21 connect to mqtt broker by name
    [gateway.py, syscfg.yml]
2021-01-21 do not print too much
    [gateway.py]
2021-01-21 fix ccp function control bug
    [main.c, syscfg.yml]
2021-01-21 fix wireshark capture firmware bugs
    [main.c]
2021-01-25 upper case
2021-01-25 update frame position
